Wizcat22/HeRo-Mini/Hardware/Part/PCB/Controller.step

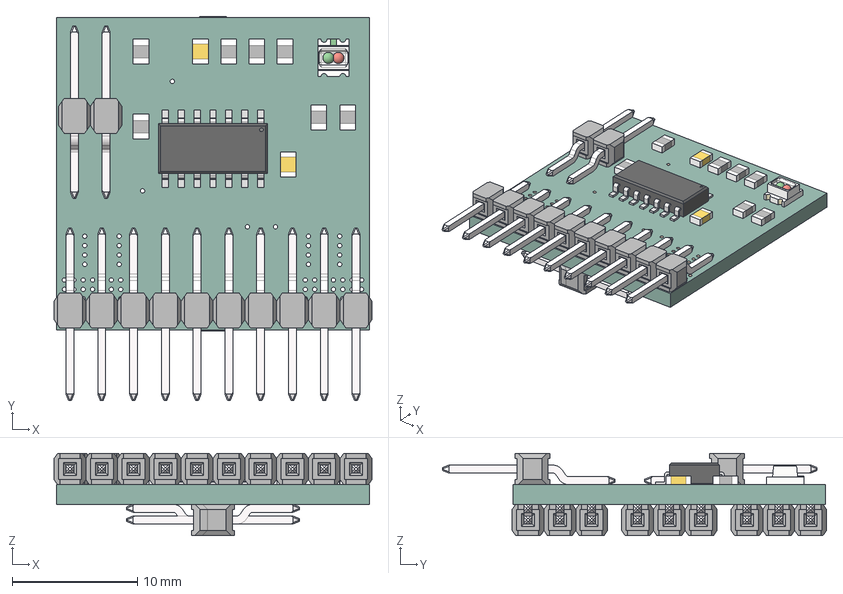
[picture p1: CAD file, 2018-07-30]
Hardware/Part/PCB/Controller.step
25.4 x 30.7 x 6.57 mm
Board
100nF x 2
10k x 7
ATTINY16142
1002386 | 00 | SL 1 IK x 6
1009987 | 00 | KSL 13,9 x 18
1002386 | 00 | SL 1 IK (1)
1009987 | 00 | KSL 13,9 (1) x 10
1002386 | 00 | SL 1 IK (2)
1009987 | 00 | KSL 13,9 (2) x 2
DUO_LED
