Wizcat22/HeRo-Mini/Hardware/STL/HIP.stl

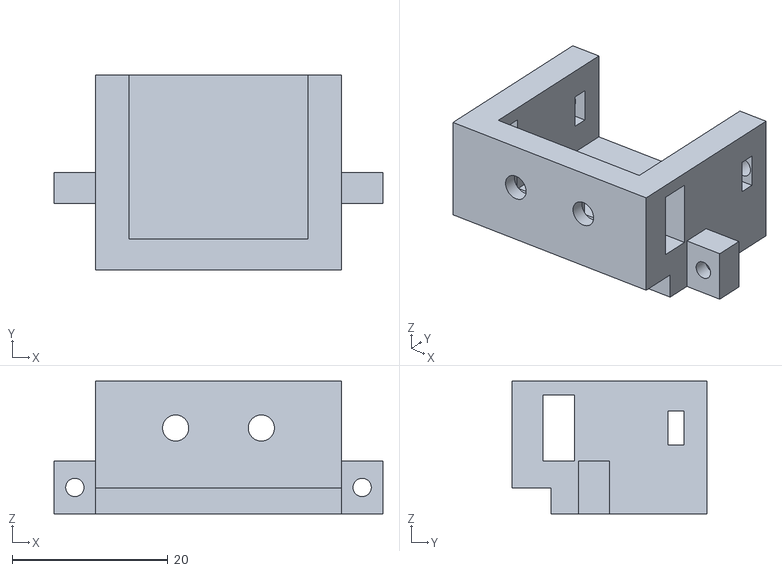
[picture p2: CAD file, 2018-09-26]
Hardware/STL/HIP.stl
42.2 x 25.0 x 17.0
