Wizcat22/HeRo-Mini/Hardware/STL/BODY_COVER.stl

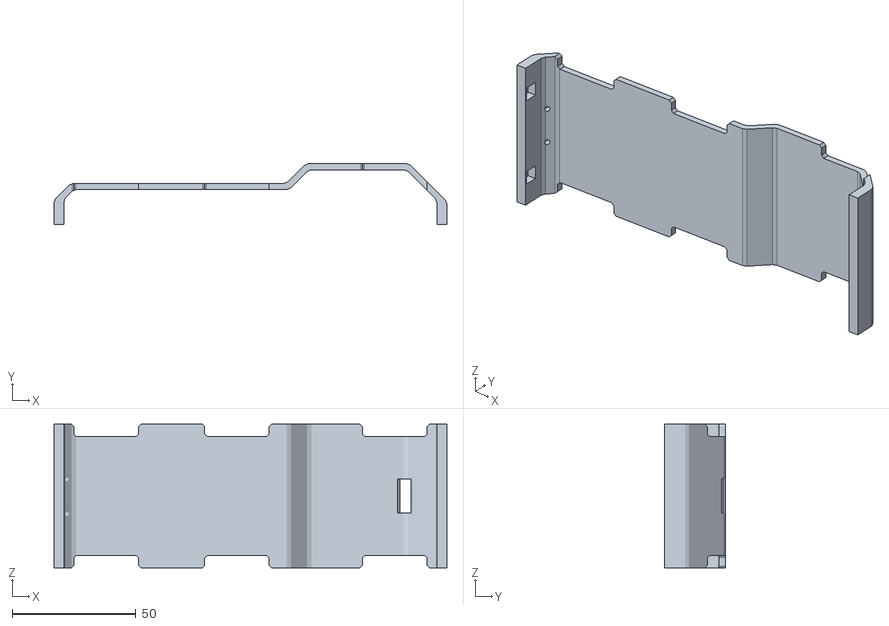
[picture p3: CAD file, 2018-09-26]
Hardware/STL/BODY_COVER.stl
158.7 x 24.6 x 58.0
