Wizcat22/HeRo-Mini/Hardware/STL/BODY_BOTTOM.stl

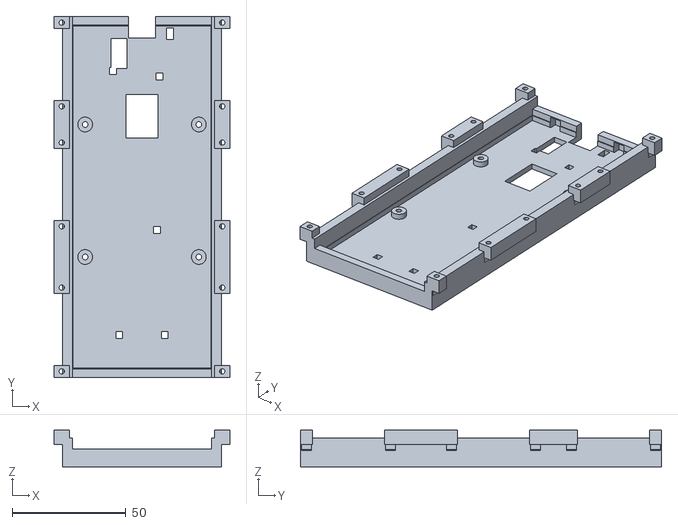
[picture p4: CAD file, 2018-09-26]
Hardware/STL/BODY_BOTTOM.stl
77.3 x 158.7 x 16.2
