Wizcat22/HeRo-Mini/Hardware/STL/FEMUR.stl

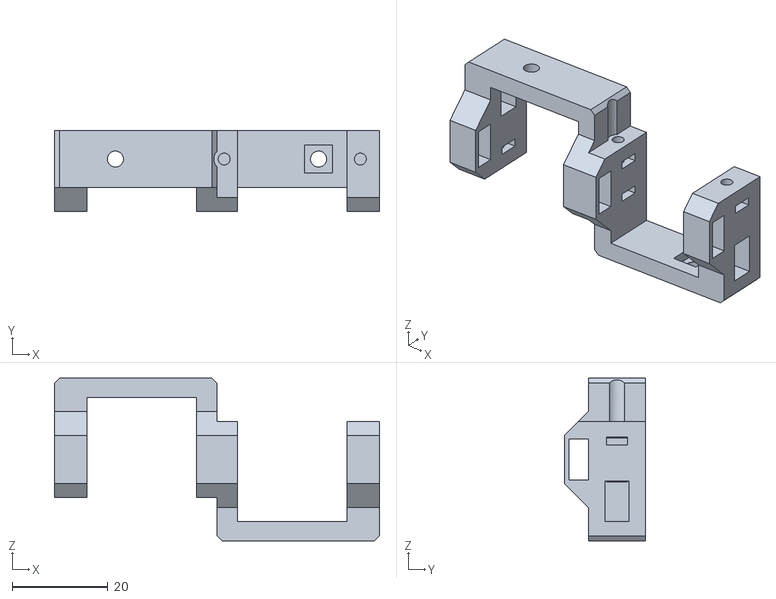
[picture p5: CAD file, 2018-09-26]
Hardware/STL/FEMUR.stl
68.0 x 17.0 x 34.0
