Wizcat22/HeRo-Mini/(list of files, cad)

Other CAD files:
Hardware/Assembly/Controller.iam
Hardware/Assembly/HeRoMini2.iam
Hardware/Assembly/LEG.iam
Hardware/Assembly/LEG2.iam
Hardware/Assembly/SERVO.iam
Hardware/Part/Design/BODY_BOTTOM.ipt
Hardware/Part/Design/BODY_COVER.ipt
Hardware/Part/Design/COXA.ipt
Hardware/Part/Design/FEMUR.ipt
Hardware/Part/Design/HIP.ipt
Hardware/Part/Design/TIBIA.ipt
Hardware/Part/Hardware/BEARING.ipt
Hardware/Part/Hardware/M2_SCREW_10MM.ipt
Hardware/Part/Hardware/M2_SCREW_6MM.ipt
Hardware/Part/Hardware/M2_SCREW_8MM.ipt
Hardware/Part/Hardware/M3_SCREW_20MM.ipt
Hardware/Part/Hardware/M3_SCREW_8MM.ipt
Hardware/Part/Hardware/M3_WASHER.ipt
Hardware/Part/Hardware/MAGNET.ipt
Hardware/Part/Hardware/NUT_2MM.ipt
Hardware/Part/Hardware/NUT_3MM.ipt
Hardware/Part/Hardware/OldVersions/M2_SCREW_10MM.0007.ipt
Hardware/Part/Misc/SPACER.ipt
Hardware/Part/Misc/TOLERANCE_TEST.ipt
Hardware/Part/Misc/TP-MG92B.ipt
Hardware/Part/Misc/TP-MG92B_HAT.ipt
Hardware/Part/PCB/IMU.ipt
Hardware/Part/PCB/Regulator1.ipt
Hardware/Part/PCB/Regulator2.ipt
