Wizcat22/HeRo-Mini/PCB/Prototype/Prototype.brd

## EAGLE design PCB/Prototype/Prototype.brd (2018-11-12)

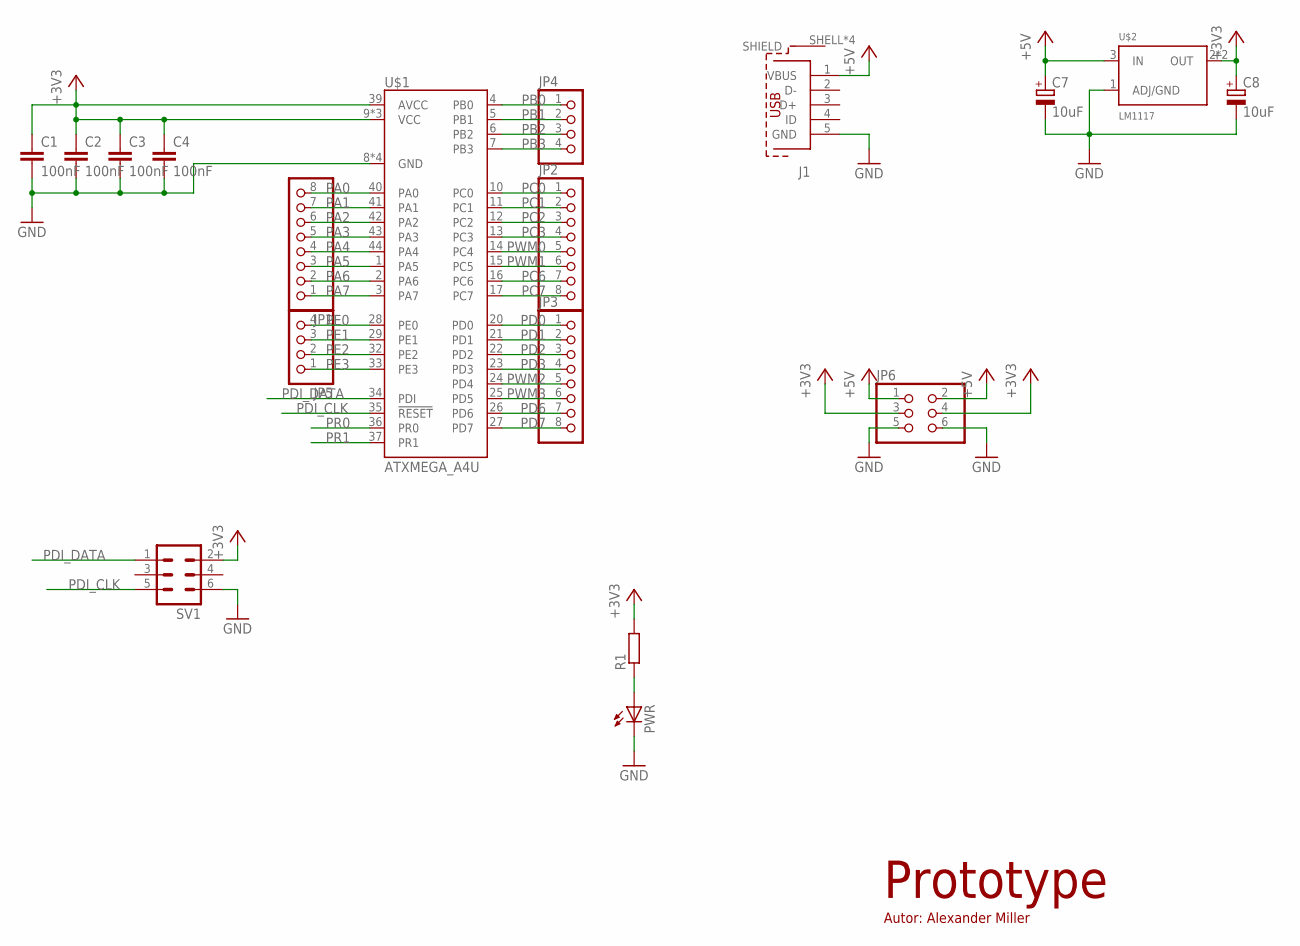
[picture p6: schematic Prototype.sch]

Parts:
C1, C2, C3, C4: 100nF; C0805
C7, C8: 10uF; SMC_P
J1: 629105136821
JP1, JP2, JP3: PINHD-1X8; 1X08
JP4, JP5: PINHD-1X4; 1X04
JP6: PINHD-2X3; 2X03
PWR: LEDSML0805; SML0805
R1: R-EU_R0805; R0805
SV1: ML6
U$1: ATXMEGA_A4U; QFP80P1200X1200X120-44
U$2: LM1117; SOT223

Connections:
+3V3: C1.1, C2.1, C3.1, C4.1, C8.+, JP6.3, JP6.4, R1.2, SV1.2, U$1.9 (VCC), U$1.19 (VCC), U$1.31 (VCC), U$1.39 (AVCC), U$2.2 (OUT), U$2.4 (OUT)
+5V: C7.+, J1.1 (VBUS), JP6.1, JP6.2, U$2.3 (IN)
GND: C1.2, C2.2, C3.2, C4.2, C7.-, C8.-, J1.5 (GND), JP6.5, JP6.6, PWR.C, SV1.6, U$1.8 (GND), U$1.18 (GND), U$1.30 (GND), U$1.38 (GND), U$2.1 (ADJ/GND)
unnamed: PWR.A, R1.1
PA0: JP1.8, U$1.40 (PA0)
PA1: JP1.7, U$1.41 (PA1)
PA2: JP1.6, U$1.42 (PA2)
PA3: JP1.5, U$1.43 (PA3)
PA4: JP1.4, U$1.44 (PA4)
PA5: JP1.3, U$1.1 (PA5)
PA6: JP1.2, U$1.2 (PA6)
PA7: JP1.1, U$1.3 (PA7)
PB0: JP4.1, U$1.4 (PB0)
PB1: JP4.2, U$1.5 (PB1)
PB2: JP4.3, U$1.6 (PB2)
PB3: JP4.4, U$1.7 (PB3)
PC0: JP2.1, U$1.10 (PC0)
PC1: JP2.2, U$1.11 (PC1)
PC2: JP2.3, U$1.12 (PC2)
PC3: JP2.4, U$1.13 (PC3)
PC6: JP2.7, U$1.16 (PC6)
PC7: JP2.8, U$1.17 (PC7)
PD0: JP3.1, U$1.20 (PD0)
PD1: JP3.2, U$1.21 (PD1)
PD2: JP3.3, U$1.22 (PD2)
PD3: JP3.4, U$1.23 (PD3)
PD6: JP3.7, U$1.26 (PD6)
PD7: JP3.8, U$1.27 (PD7)
PDI_CLK: SV1.5, U$1.35 (!RESET)
PDI_DATA: SV1.1, U$1.34 (PDI)
PE0: JP5.4, U$1.28 (PE0)
PE1: JP5.3, U$1.29 (PE1)
PE2: JP5.2, U$1.32 (PE2)
PE3: JP5.1, U$1.33 (PE3)
PR0: U$1.36 (PR0)
PR1: U$1.37 (PR1)
PWM0: JP2.5, U$1.14 (PC4)
PWM1: JP2.6, U$1.15 (PC5)
PWM2: JP3.5, U$1.24 (PD4)
PWM3: JP3.6, U$1.25 (PD5)

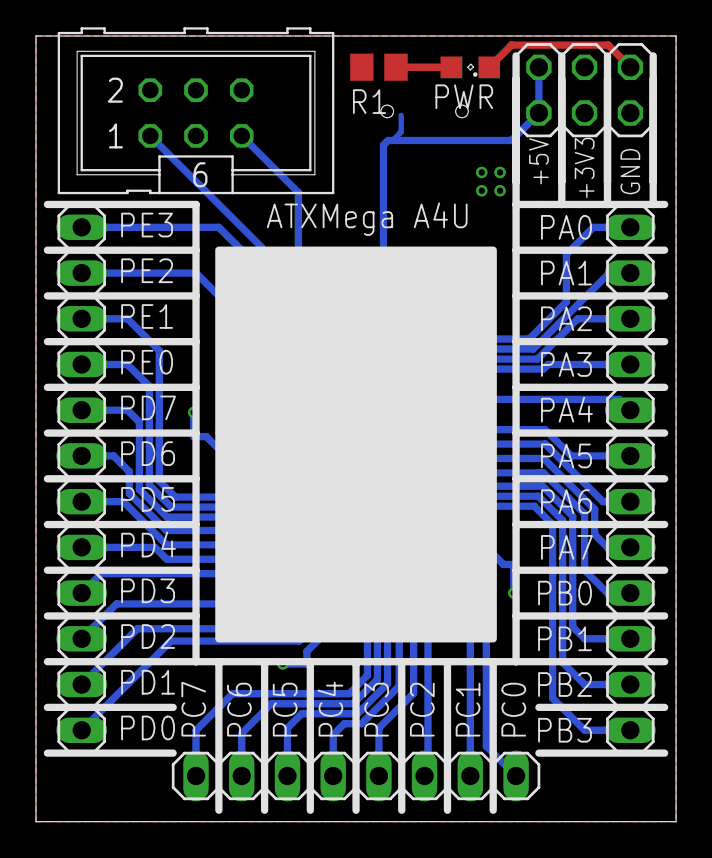
[picture p7: board Prototype.brd from above]

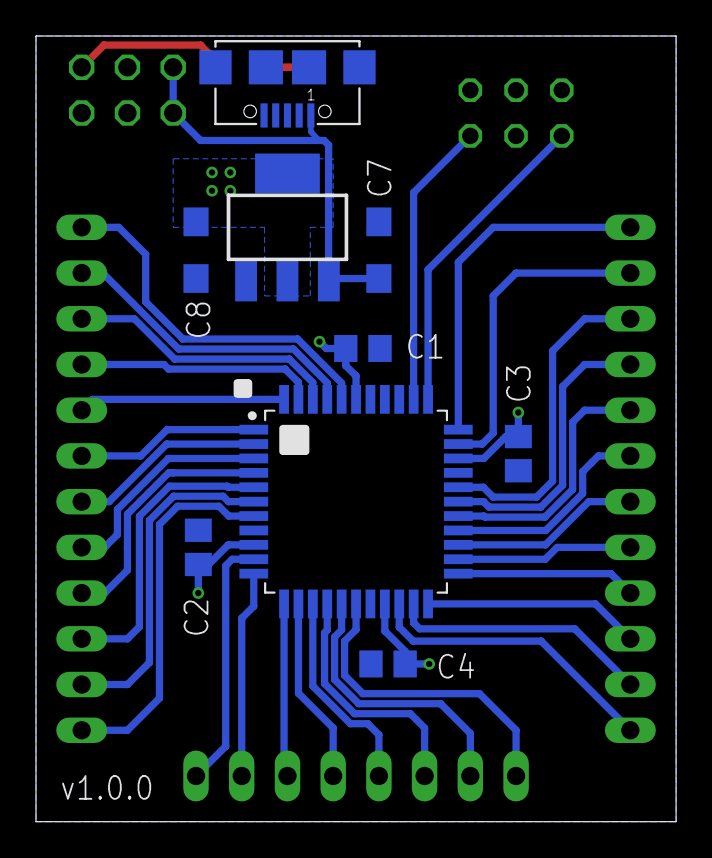
[picture p8: board Prototype.brd from below]

Board: 2 copper layers, 35.6 x 43.6 mm, 18 parts (9 on the bottom side), 38 nets.
