Wizcat22/HeRo-Mini/PCB/Gamepad/Gamepad.brd

## EAGLE design PCB/Gamepad/Gamepad.brd (2018-11-12)

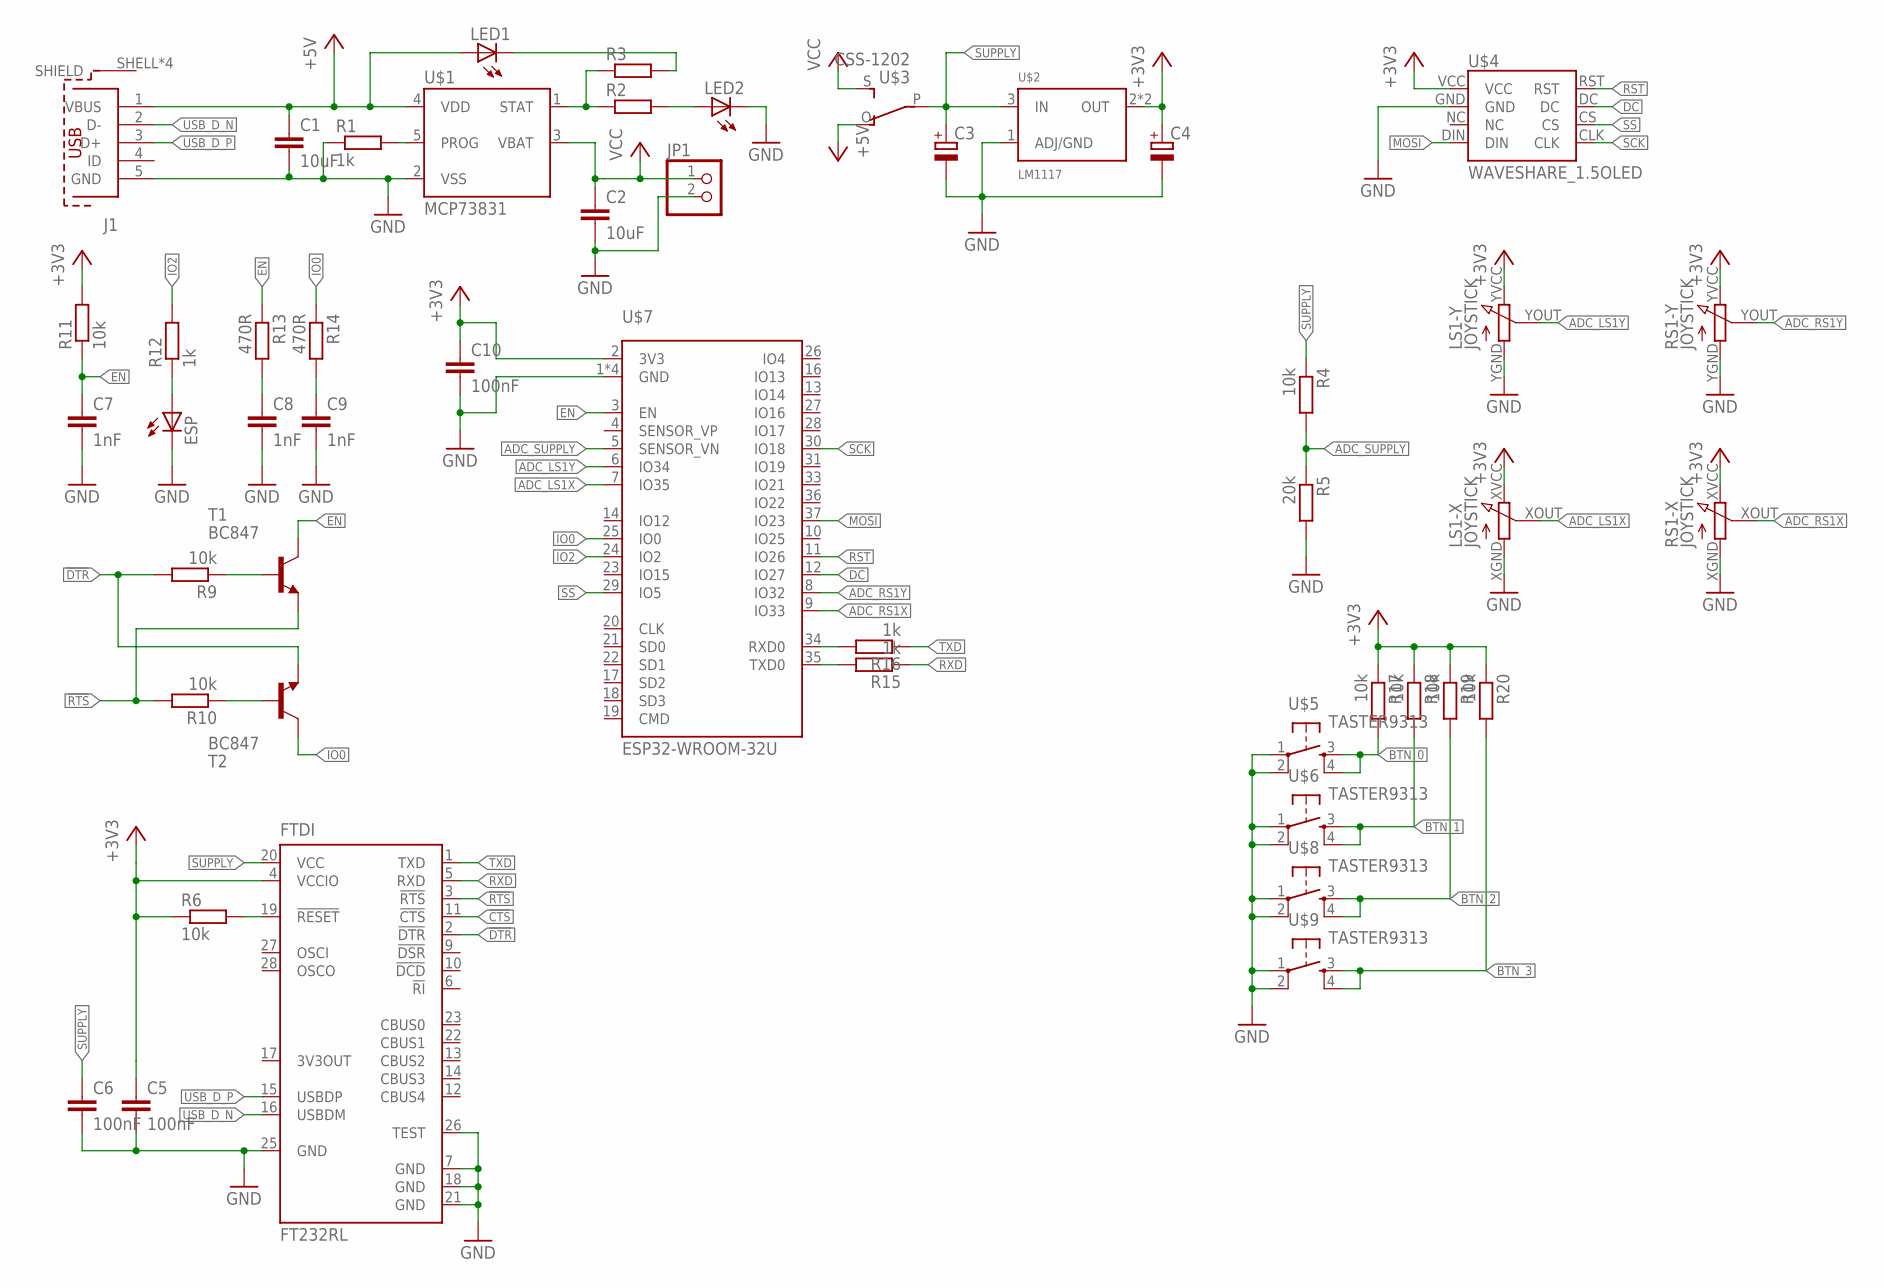
[picture p9: schematic Gamepad.sch]

Parts:
C1, C2: 10uF; C0805
C3, C4: CPOL-EUSMCP; SMC_P
C5, C6, C10: 100nF; C0805
C7, C8, C9: 1nF; C0805
ESP: LEDCHIP-LED0805; CHIP-LED0805
FTDI: FT232RL; SSOP28
J1: 629105136821
JP1: PINHD-1X2; 1X02
LED1, LED2: LED3MM
LS1: JOYSTICK
R1, R12, R15, R16: 1k; R0805
R2, R3: R-EU_R0805; R0805
R4, R6, R9, R10, R11, R17, R18, R19, R20: 10k; R0805
R5: 20k; R0805
R13, R14: 470R; R0805
RS1: JOYSTICK
T1, T2: BC847; SOT23
U$1: MCP73831; SOT95P280X145-5
U$2: LM1117; SOT223
U$3: CSS-1202
U$4: WAVESHARE_1.5OLED
U$5, U$6, U$8, U$9: TASTER9313
U$7: ESP32-WROOM-32U

Connections:
!CTS: FTDI.11 (!CTS)
!DTR: FTDI.2 (!DTR), R9.2, T2.2 (E)
!RTS: FTDI.3 (!RTS), R10.2, T1.2 (E)
+3V3: C4.+, C5.1, C10.1, FTDI.4 (VCCIO), LS1.XVCC (VCC), LS1.YVCC (VCC), R6.1, R11.2, R17.1, R18.1, R19.1, R20.1, RS1.XVCC (VCC), RS1.YVCC (VCC), U$2.2 (OUT), U$2.4 (OUT), U$4.VCC, U$7.2 (3V3)
+5V: C1.1, J1.1 (VBUS), LED1.A, U$1.4 (VDD), U$3.O
ADC_LS1X: LS1.XOUT (OUT), U$7.7 (IO35)
ADC_LS1Y: LS1.YOUT (OUT), U$7.6 (IO34)
ADC_RS1X: RS1.XOUT (OUT), U$7.9 (IO33)
ADC_RS1Y: RS1.YOUT (OUT), U$7.8 (IO32)
ADC_SUPPLY: R4.2, R5.1, U$7.5 (SENSOR_VN)
BTN_0: R17.2, U$5.3 (S), U$5.4 (S1)
BTN_1: R18.2, U$6.3 (S), U$6.4 (S1)
BTN_2: R19.2, U$8.3 (S), U$8.4 (S1)
BTN_3: R20.2, U$9.3 (S), U$9.4 (S1)
DC: U$4.DC, U$7.12 (IO27)
EN: C7.1, R11.1, R13.1, T1.3 (C), U$7.3 (EN)
GND: C1.2, C2.2, C3.-, C4.-, C5.2, C6.2, C7.2, C8.2, C9.2, C10.2, ESP.C, FTDI.7 (GND), FTDI.18 (GND), FTDI.21 (GND), FTDI.25 (GND), FTDI.26 (TEST), J1.5 (GND), JP1.2, LED2.K (C), LS1.XGND (GND), LS1.YGND (GND), R1.1, R5.2, RS1.XGND (GND), RS1.YGND (GND), U$1.2 (VSS), U$2.1 (ADJ/GND), U$4.GND, U$5.1, U$5.2 (P1), U$6.1, U$6.2 (P1), U$7.1 (GND), U$7.15 (GND), U$7.38 (GND), U$7.39 (GND), U$8.1, U$8.2 (P1), U$9.1, U$9.2 (P1)
IO0: R14.1, T2.3 (C), U$7.25 (IO0)
IO2: R12.2, U$7.24 (IO2)
MOSI: U$4.DIN, U$7.37 (IO23)
unnamed: R2.1, R3.1, U$1.1 (STAT)
unnamed: FTDI.19 (!RESET), R6.2
unnamed: R1.2, U$1.5 (PROG)
unnamed: LED1.K (C), R3.2
unnamed: LED2.A, R2.2
unnamed: R9.1, T1.1 (B)
unnamed: R10.1, T2.1 (B)
unnamed: ESP.A, R12.1
unnamed: C8.1, R13.2
unnamed: C9.1, R14.2
unnamed: R16.2, U$7.34 (RXD0)
unnamed: R15.2, U$7.35 (TXD0)
RST: U$4.RST, U$7.11 (IO26)
RXD: FTDI.5 (RXD), R15.1
SCK: U$4.CLK, U$7.30 (IO18)
SS: U$4.CS, U$7.29 (IO5)
SUPPLY: C3.+, C6.1, FTDI.20 (VCC), R4.1, U$2.3 (IN), U$3.P
TXD: FTDI.1 (TXD), R16.1
USB_D_N: FTDI.16 (USBDM), J1.2 (D-)
USB_D_P: FTDI.15 (USBDP), J1.3 (D+)
VCC: C2.1, JP1.1, U$1.3 (VBAT), U$3.S

Board: 2 copper layers, 47 parts (31 on the bottom side), 40 nets, no tracks yet.
