Wizcat22/HeRo-Mini/PCB/Mainboard/Mainboard.brd

## EAGLE design PCB/Mainboard/Mainboard.brd (2018-07-30)

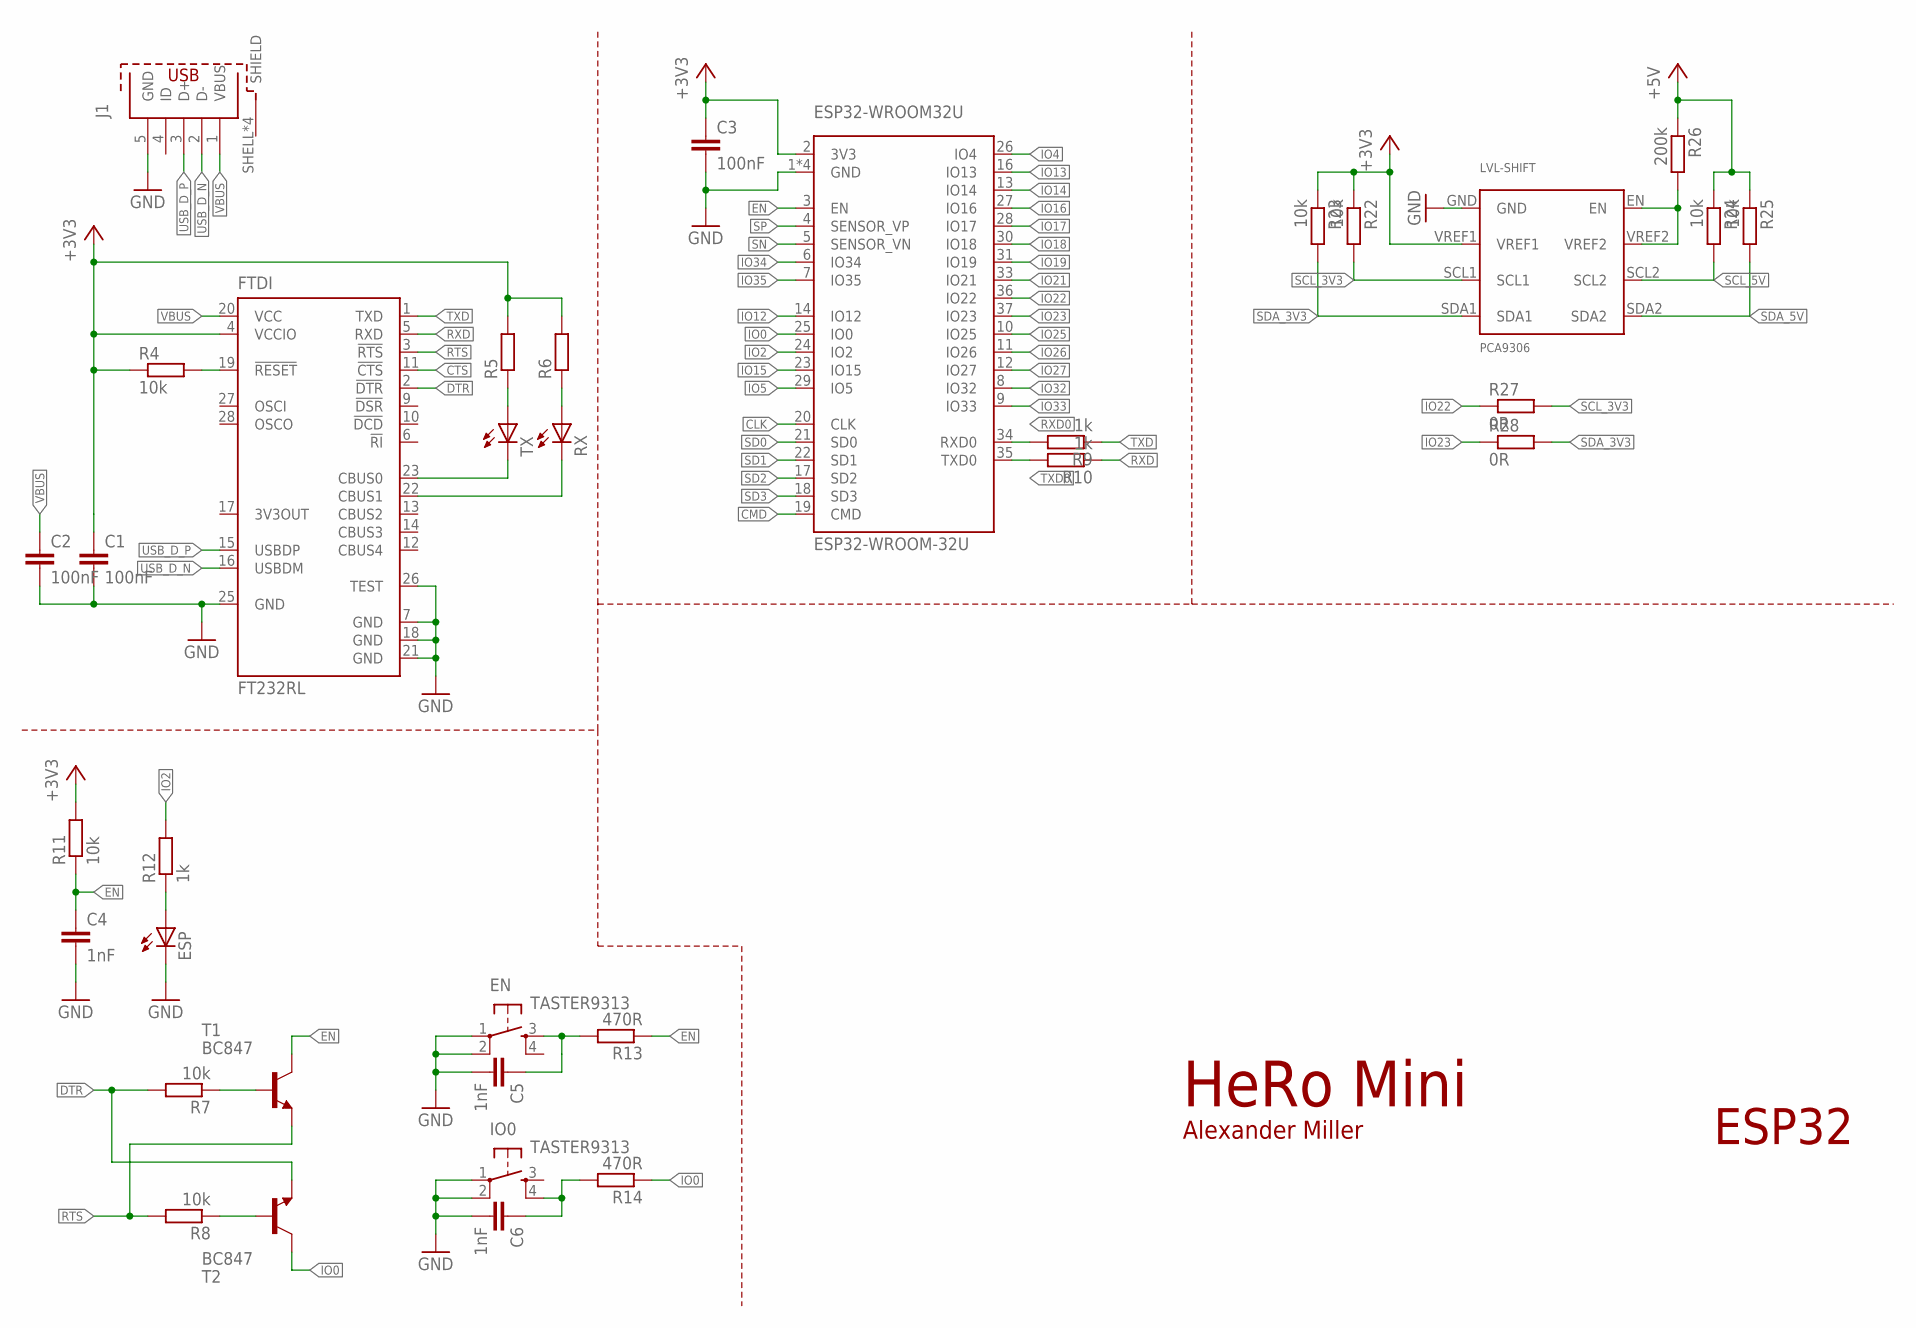
[picture p10: schematic Mainboard.sch, sheet 1]

Parts:
C1, C2, C3: 100nF; C0805
C4, C5, C6: 1nF; C0805
EN: TASTER9313
ESP: LEDCHIP-LED0805; CHIP-LED0805
ESP32-WROOM32U: ESP32-WROOM-32U
FTDI: FT232RL; SSOP28
IO0: TASTER9313
J1: 629105136821
LVL-SHIFT: PCA9306
R4, R7, R8, R11, R22, R23, R24, R25: 10k; R0805
R5, R6: R-EU_R0805; R0805
R9, R10, R12: 1k; R0805
R13, R14: 470R; R0805
R26: 200k; R0805
R27, R28: 0R; R0805
RX: LEDCHIP-LED0805; CHIP-LED0805
T1, T2: BC847; SOT23
TX: LEDCHIP-LED0805; CHIP-LED0805

Connections:
!CTS: FTDI.11 (!CTS)
!DTR: FTDI.2 (!DTR), R7.2, T2.2 (E)
!RTS: FTDI.3 (!RTS), R8.2, T1.2 (E)
+3V3: C1.1, C3.1, ESP32-WROOM32U.2 (3V3), FTDI.4 (VCCIO), LVL-SHIFT.VREF1, R4.1, R5.2, R6.2, R11.2, R22.1, R23.1; also elsewhere on the board
+5V: R24.1, R25.1, R26.1; also elsewhere on the board
CLK: ESP32-WROOM32U.20 (CLK)
CMD: ESP32-WROOM32U.19 (CMD)
EN: C4.1, ESP32-WROOM32U.3 (EN), R11.1, R13.1, T1.3 (C)
GND: C1.2, C2.2, C3.2, C4.2, C5.2, C6.2, EN.1, EN.2 (P1), ESP.C, ESP32-WROOM32U.1 (GND), ESP32-WROOM32U.15 (GND), ESP32-WROOM32U.38 (GND), ESP32-WROOM32U.39 (GND), FTDI.7 (GND), FTDI.18 (GND), FTDI.21 (GND), FTDI.25 (GND), FTDI.26 (TEST), IO0.1, IO0.2 (P1), J1.5 (GND), LVL-SHIFT.GND; also elsewhere on the board
IO0: ESP32-WROOM32U.25 (IO0), R14.1, T2.3 (C)
IO2: ESP32-WROOM32U.24 (IO2), R12.2
IO4: ESP32-WROOM32U.26 (IO4)
IO5: ESP32-WROOM32U.29 (IO5)
IO12: ESP32-WROOM32U.14 (IO12)
IO13: ESP32-WROOM32U.16 (IO13)
IO14: ESP32-WROOM32U.13 (IO14)
IO15: ESP32-WROOM32U.23 (IO15)
IO16: ESP32-WROOM32U.27 (IO16)
IO17: ESP32-WROOM32U.28 (IO17)
IO18: ESP32-WROOM32U.30 (IO18)
IO19: ESP32-WROOM32U.31 (IO19)
IO21: ESP32-WROOM32U.33 (IO21)
IO22: ESP32-WROOM32U.36 (IO22), R27.1
IO23: ESP32-WROOM32U.37 (IO23), R28.1
IO25: ESP32-WROOM32U.10 (IO25)
IO26: ESP32-WROOM32U.11 (IO26)
IO27: ESP32-WROOM32U.12 (IO27)
IO32: ESP32-WROOM32U.8 (IO32)
IO33: ESP32-WROOM32U.9 (IO33)
IO34: ESP32-WROOM32U.6 (IO34)
IO35: ESP32-WROOM32U.7 (IO35)
unnamed: FTDI.19 (!RESET), R4.2
unnamed: FTDI.23 (CBUS0), TX.C
unnamed: FTDI.22 (CBUS1), RX.C
unnamed: R5.1, TX.A
unnamed: R6.1, RX.A
unnamed: R7.1, T1.1 (B)
unnamed: R8.1, T2.1 (B)
unnamed: ESP.A, R12.1
unnamed: C5.1, EN.3 (S), R13.2
unnamed: C6.1, IO0.4 (S1), R14.2
unnamed: LVL-SHIFT.EN, LVL-SHIFT.VREF2, R26.2
RXD: FTDI.5 (RXD), R10.1
RXD0: ESP32-WROOM32U.34 (RXD0), R9.2
SCL_3V3: LVL-SHIFT.SCL1, R22.2, R27.2
SCL_5V: LVL-SHIFT.SCL2, R24.2; also elsewhere on the board
SD0: ESP32-WROOM32U.21 (SD0)
SD1: ESP32-WROOM32U.22 (SD1)
SD2: ESP32-WROOM32U.17 (SD2)
SD3: ESP32-WROOM32U.18 (SD3)
SDA_3V3: LVL-SHIFT.SDA1, R23.2, R28.2
SDA_5V: LVL-SHIFT.SDA2, R25.2; also elsewhere on the board
SN: ESP32-WROOM32U.5 (SENSOR_VN)
SP: ESP32-WROOM32U.4 (SENSOR_VP)
TXD: FTDI.1 (TXD), R9.1
TXD0: ESP32-WROOM32U.35 (TXD0), R10.2
USB_D_N: FTDI.16 (USBDM), J1.2 (D-)
USB_D_P: FTDI.15 (USBDP), J1.3 (D+)
VBUS: C2.1, FTDI.20 (VCC), J1.1 (VBUS)

Notes on the sheet:
ESP32

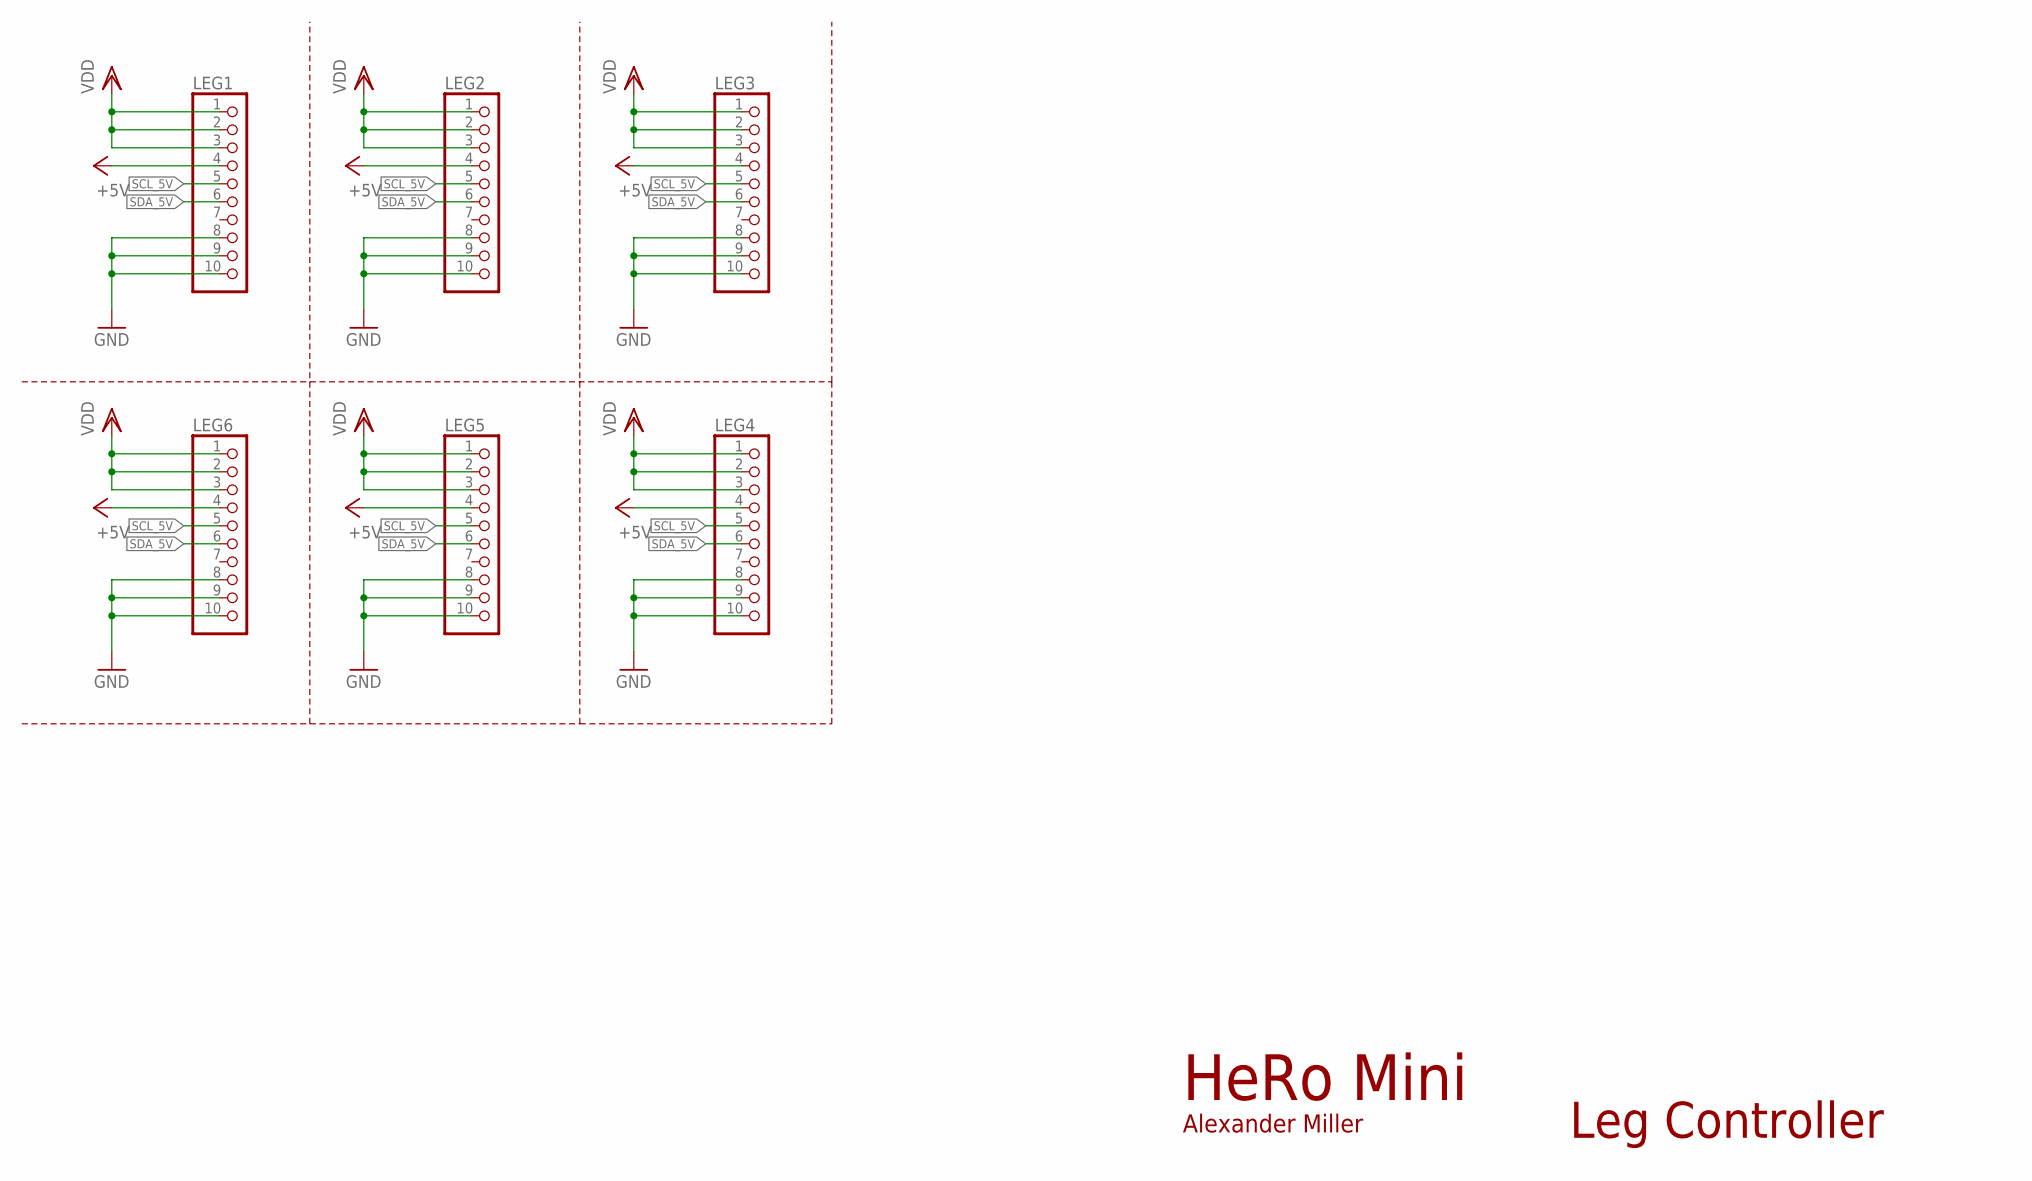
[picture p11: schematic Mainboard.sch, sheet 2]

Parts:
LEG1, LEG2, LEG3, LEG4, LEG5, LEG6: PINHD-1X10; 1X10

Connections:
+5V: LEG1.4, LEG2.4, LEG3.4, LEG4.4, LEG5.4, LEG6.4; also elsewhere on the board
GND: LEG1.8, LEG1.9, LEG1.10, LEG2.8, LEG2.9, LEG2.10, LEG3.8, LEG3.9, LEG3.10, LEG4.8, LEG4.9, LEG4.10, LEG5.8, LEG5.9, LEG5.10, LEG6.8, LEG6.9, LEG6.10; also elsewhere on the board
SCL_5V: LEG1.5, LEG2.5, LEG3.5, LEG4.5, LEG5.5, LEG6.5; also elsewhere on the board
SDA_5V: LEG1.6, LEG2.6, LEG3.6, LEG4.6, LEG5.6, LEG6.6; also elsewhere on the board
VDD: LEG1.1, LEG1.2, LEG1.3, LEG2.1, LEG2.2, LEG2.3, LEG3.1, LEG3.2, LEG3.3, LEG4.1, LEG4.2, LEG4.3, LEG5.1, LEG5.2, LEG5.3, LEG6.1, LEG6.2, LEG6.3; also elsewhere on the board

Notes on the sheet:
Leg Controller

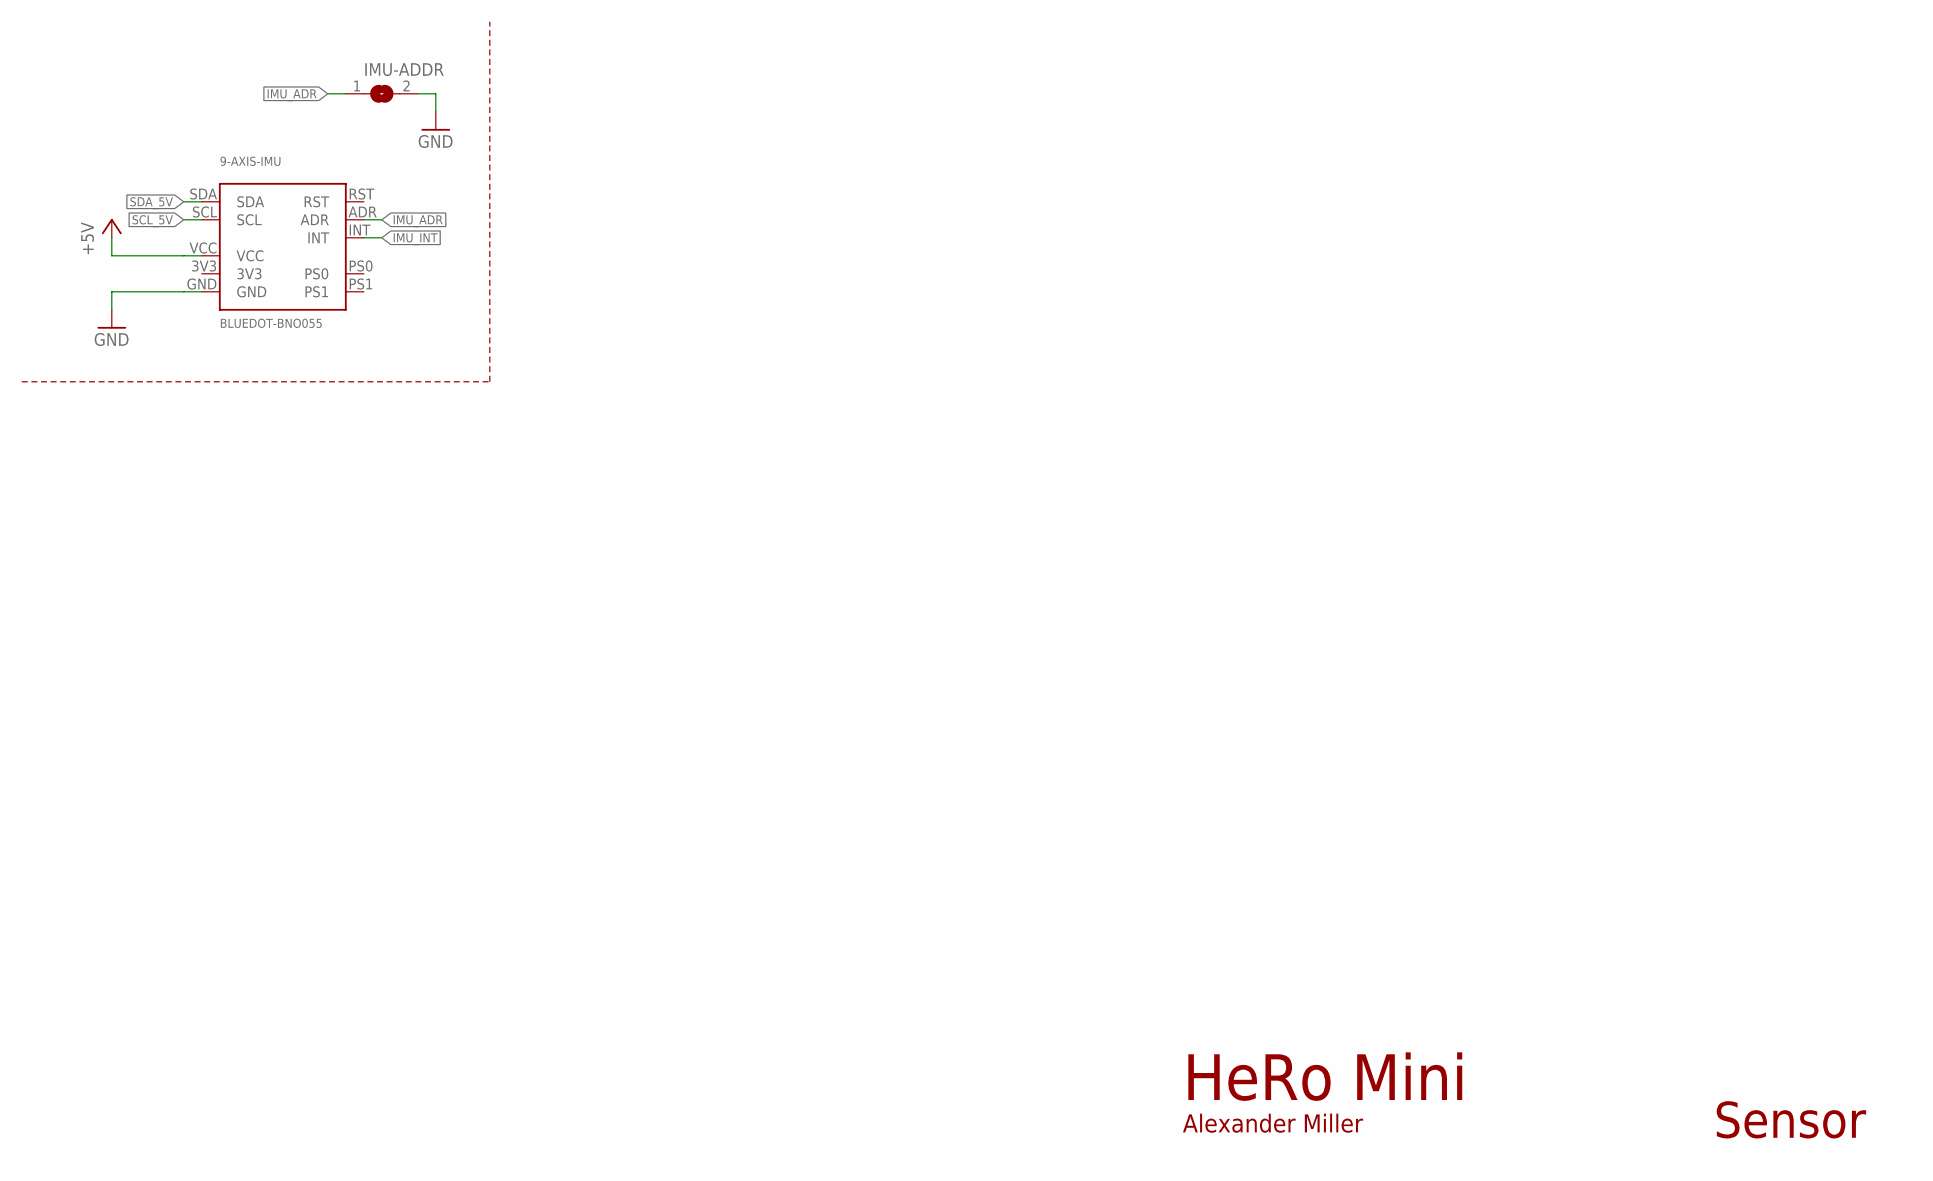
[picture p12: schematic Mainboard.sch, sheet 3]

Parts:
9-AXIS-IMU: BLUEDOT-BNO055
IMU-ADDR: SJ

Connections:
+5V: 9-AXIS-IMU.VCC; also elsewhere on the board
GND: 9-AXIS-IMU.GND, IMU-ADDR.2; also elsewhere on the board
IMU_ADR: 9-AXIS-IMU.ADR, IMU-ADDR.1
IMU_INT: 9-AXIS-IMU.INT
SCL_5V: 9-AXIS-IMU.SCL; also elsewhere on the board
SDA_5V: 9-AXIS-IMU.SDA; also elsewhere on the board

Notes on the sheet:
Sensor

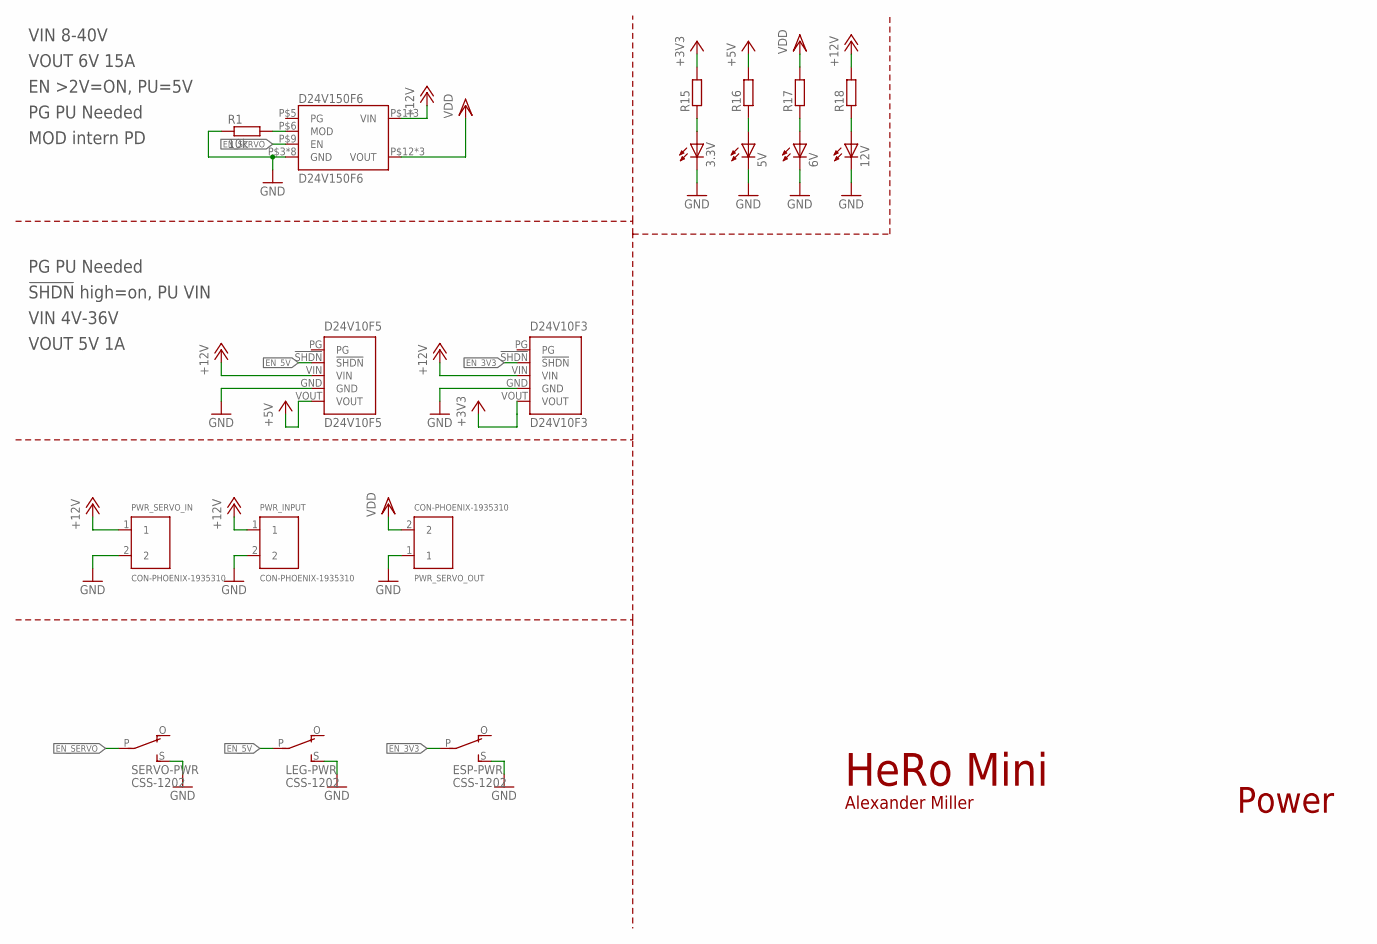
[picture p13: schematic Mainboard.sch, sheet 4]

Parts:
3.3V, 5V, 6V, 12V: LEDCHIP-LED0805; CHIP-LED0805
D24V10F3: D24V10F3; D24V10F5
D24V10F5: D24V10F5
D24V150F6: D24V150F6
ESP-PWR: CSS-1202
LEG-PWR: CSS-1202
PWR_INPUT: CON-PHOENIX-1935310
PWR_SERVO_IN: CON-PHOENIX-1935310
PWR_SERVO_OUT: CON-PHOENIX-1935310
R1: 10k; R0805
R15, R16, R17, R18: R-EU_R0805; R0805
SERVO-PWR: CSS-1202

Connections:
+3V3: D24V10F3.VOUT, R15.2; also elsewhere on the board
+5V: D24V10F5.VOUT, R16.2; also elsewhere on the board
+12V: D24V10F3.VIN, D24V10F5.VIN, D24V150F6.P$1 (VIN), D24V150F6.P$2 (VIN), D24V150F6.P$17 (VIN), PWR_INPUT.1, PWR_SERVO_IN.1, R18.2
EN_3V3: D24V10F3.!SHDN, ESP-PWR.P
EN_5V: D24V10F5.!SHDN, LEG-PWR.P
EN_SERVO: D24V150F6.P$9 (EN), SERVO-PWR.P
GND: 3.3V.C, 5V.C, 6V.C, 12V.C, D24V10F3.GND, D24V10F5.GND, D24V150F6.P$3 (GND), D24V150F6.P$4 (GND), D24V150F6.P$7 (GND), D24V150F6.P$8 (GND), D24V150F6.P$10 (GND), D24V150F6.P$11 (GND), D24V150F6.P$14 (GND), D24V150F6.P$16 (GND), ESP-PWR.S, LEG-PWR.S, PWR_INPUT.2, PWR_SERVO_IN.2, PWR_SERVO_OUT.1, R1.1, SERVO-PWR.S; also elsewhere on the board
unnamed: D24V150F6.P$6 (MOD), R1.2
unnamed: 5V.A, R16.1
unnamed: 6V.A, R17.1
unnamed: 3.3V.A, R15.1
unnamed: 12V.A, R18.1
VDD: D24V150F6.P$12 (VOUT), D24V150F6.P$13 (VOUT), D24V150F6.P$15 (VOUT), PWR_SERVO_OUT.2, R17.2; also elsewhere on the board

Notes on the sheet:
Power
VIN 8-40V
VOUT 6V 15A
EN >2V=ON, PU=5V
PG PU Needed
MOD intern PD
!SHDN! high=on, PU VIN
VIN 4V-36V
VOUT 5V 1A

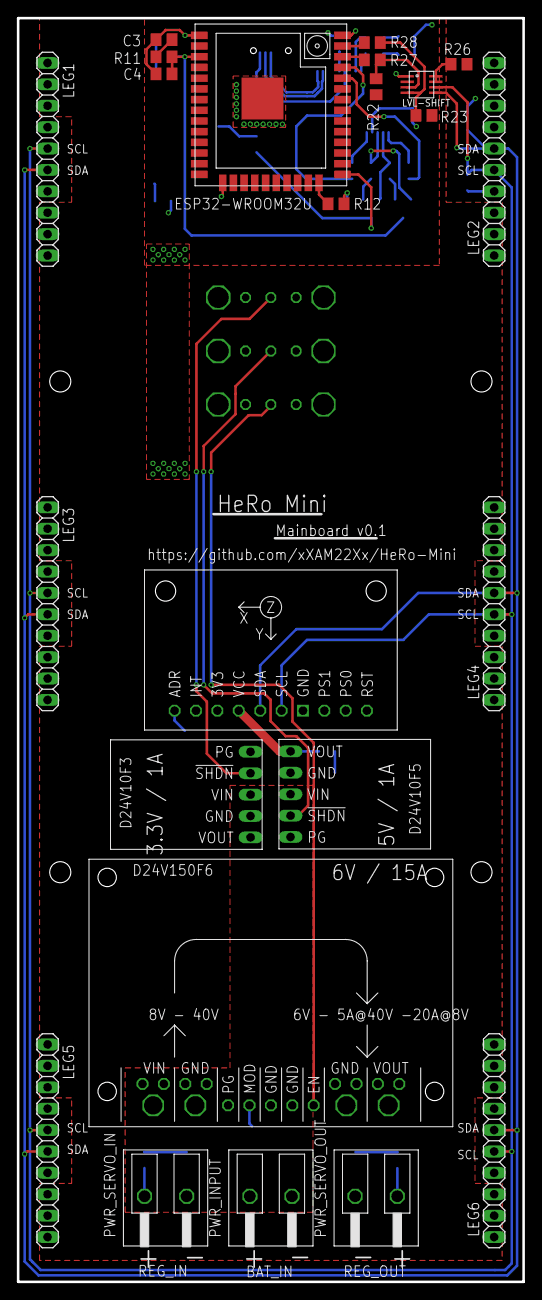
[picture p14: board Mainboard.brd from above]

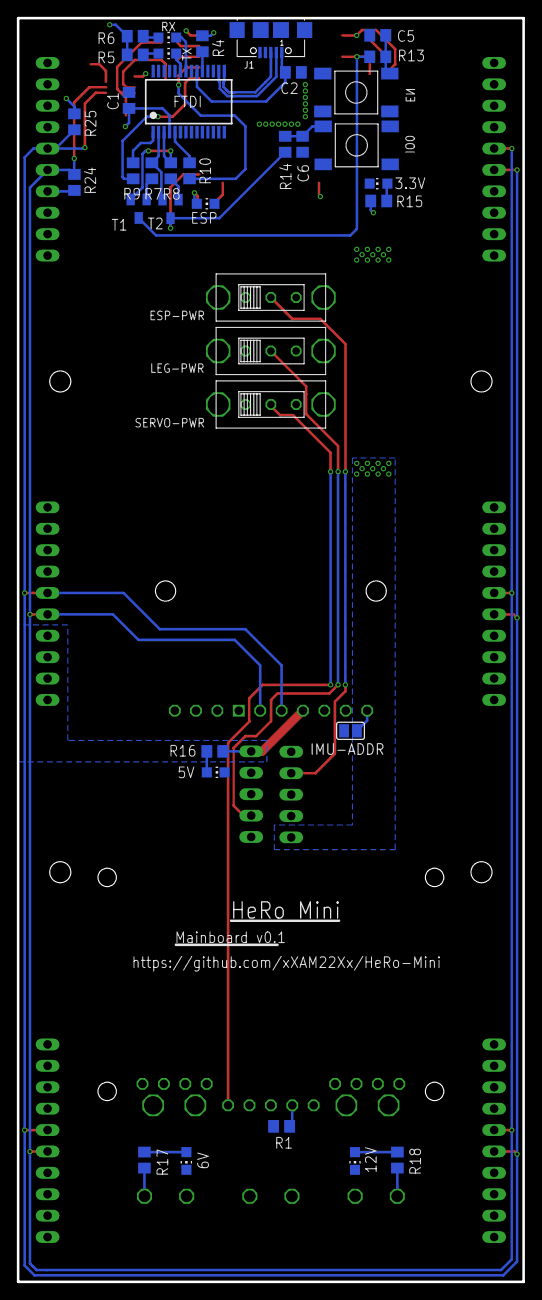
[picture p15: board Mainboard.brd from below]

Board: 2 copper layers, 60.0 x 150.0 mm, 61 parts (37 on the bottom side), 43 nets.
