Wizcat22/HeRo-Mini/PCB/Controller/Controller.brd

## EAGLE design PCB/Controller/Controller.brd (2018-07-30)

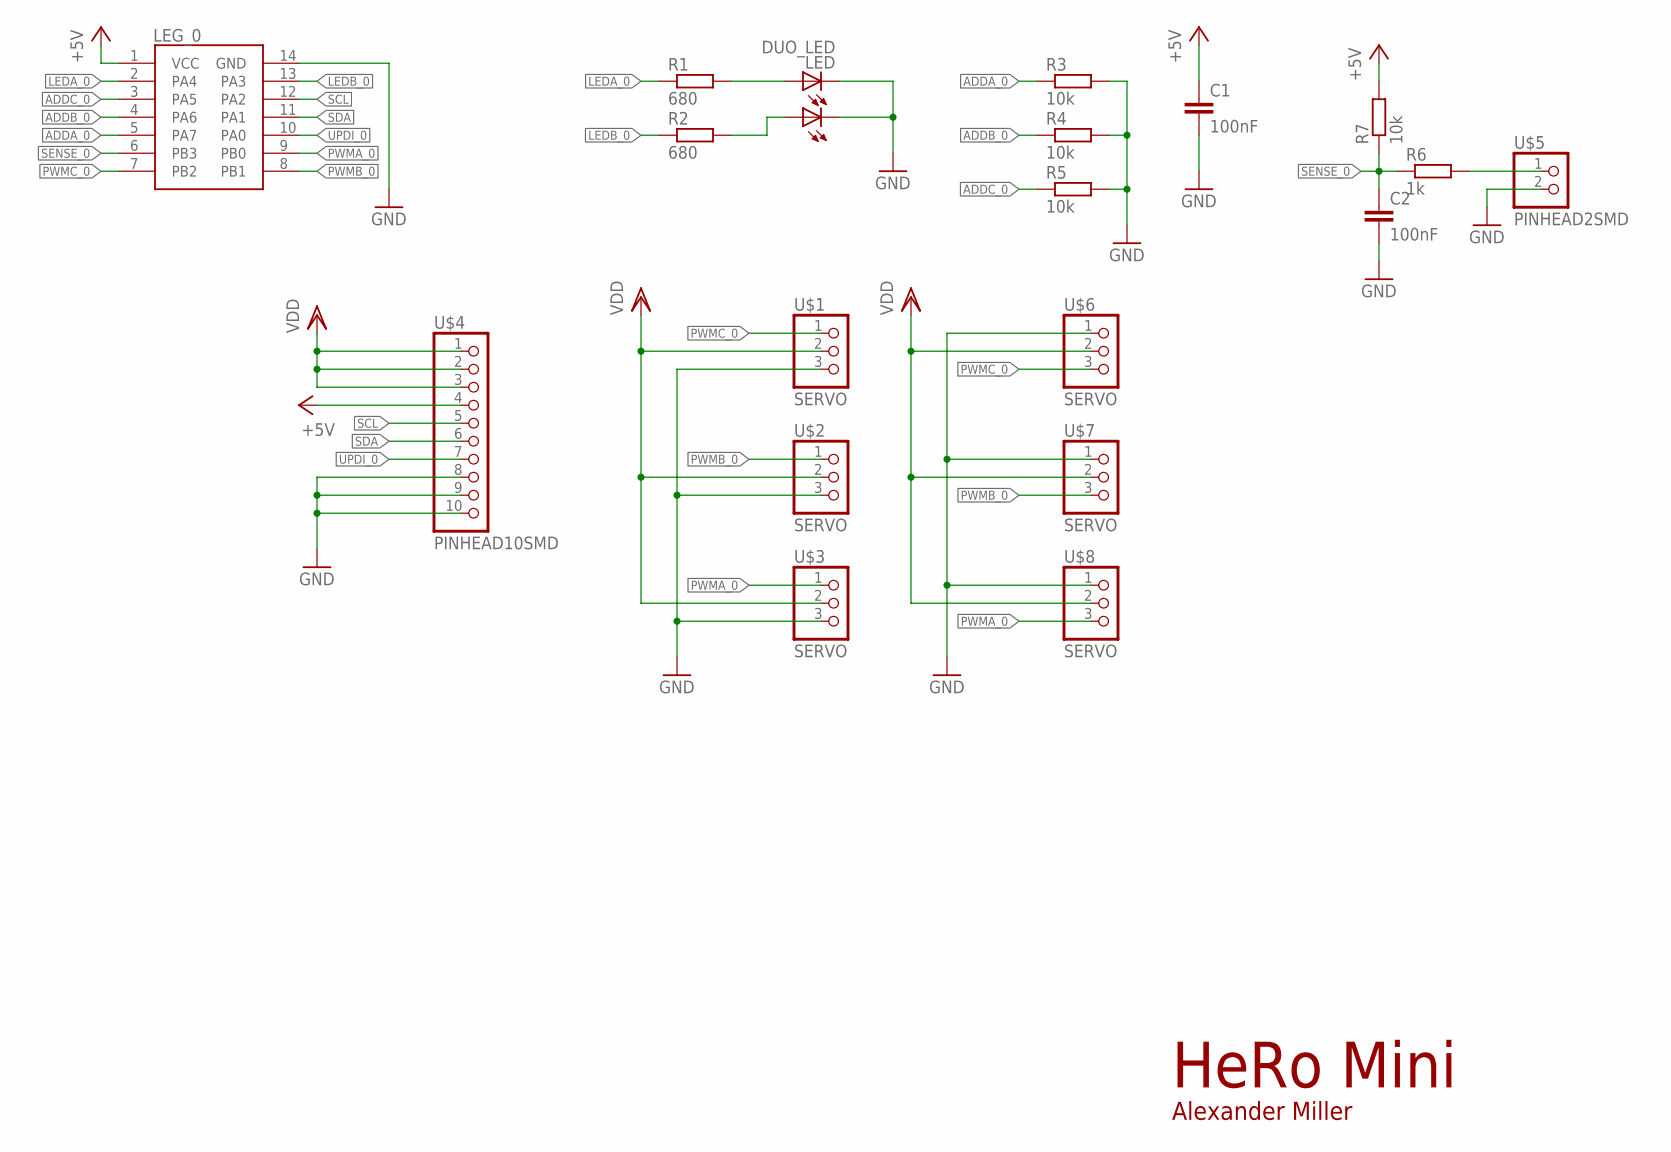
[picture p16: schematic Controller.sch, sheet 1]

Parts:
C1, C2: 100nF; C0805
LED: DUO_LED
LEG_0: ATTINY16142; SOIC127P600X175-14
R1, R2: 680; R0805
R3, R4, R5, R7: 10k; R0805
R6: 1k; R0805
U$1, U$2, U$3, U$6, U$7, U$8: SERVO; SL12SMD058
U$4: PINHEAD10SMD; PINHD10SMD
U$5: PINHEAD2SMD; PINHD2SMD

Connections:
+5V: C1.1, LEG_0.1 (VCC), R7.2, U$4.4
ADDA_0: LEG_0.5 (PA7), R3.1
ADDB_0: LEG_0.4 (PA6), R4.1
ADDC_0: LEG_0.3 (PA5), R5.1
GND: C1.2, C2.2, LED.CG, LED.CR, LEG_0.14 (GND), R3.2, R4.2, R5.2, U$1.3, U$2.3, U$3.3, U$4.8, U$4.9, U$4.10, U$5.2, U$6.1, U$7.1, U$8.1
LEDA_0: LEG_0.2 (PA4), R1.1
LEDB_0: LEG_0.13 (PA3), R2.1
unnamed: LED.AG, R1.2
unnamed: LED.AR, R2.2
unnamed: R6.2, U$5.1
PWMA_0: LEG_0.9 (PB0), U$3.1, U$8.3
PWMB_0: LEG_0.8 (PB1), U$2.1, U$7.3
PWMC_0: LEG_0.7 (PB2), U$1.1, U$6.3
SCL: LEG_0.12 (PA2), U$4.5
SDA: LEG_0.11 (PA1), U$4.6
SENSE_0: C2.1, LEG_0.6 (PB3), R6.1, R7.1
UPDI_0: LEG_0.10 (PA0), U$4.7
VDD: U$1.2, U$2.2, U$3.2, U$4.1, U$4.2, U$4.3, U$6.2, U$7.2, U$8.2

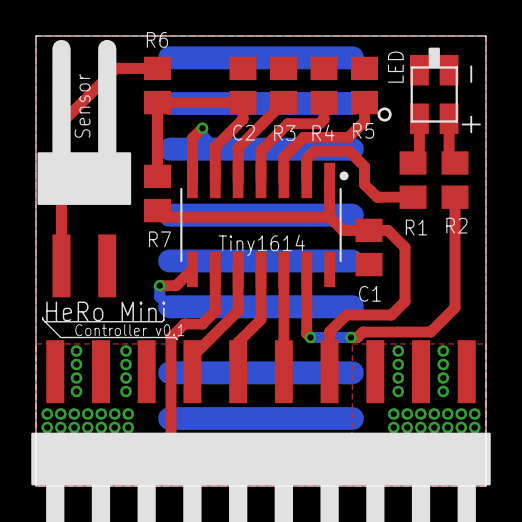
[picture p17: board Controller.brd from above]

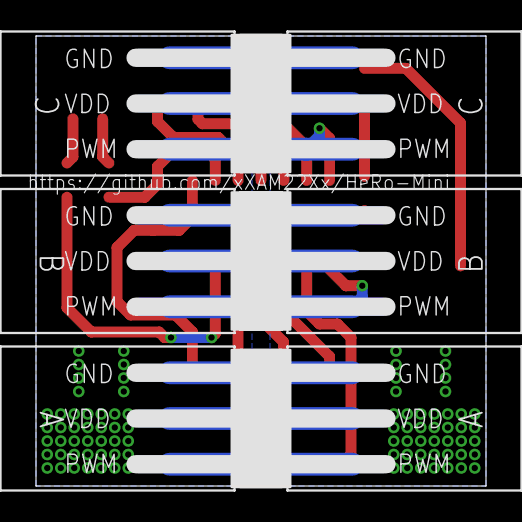
[picture p18: board Controller.brd from below]

Board: 2 copper layers, 25.0 x 25.0 mm, 19 parts (6 on the bottom side), 18 nets.
