Wizcat22/HeRo-Mini/PCB/2x2_DPad.brd

## EAGLE design PCB/2x2_DPad.brd (2018-03-26)

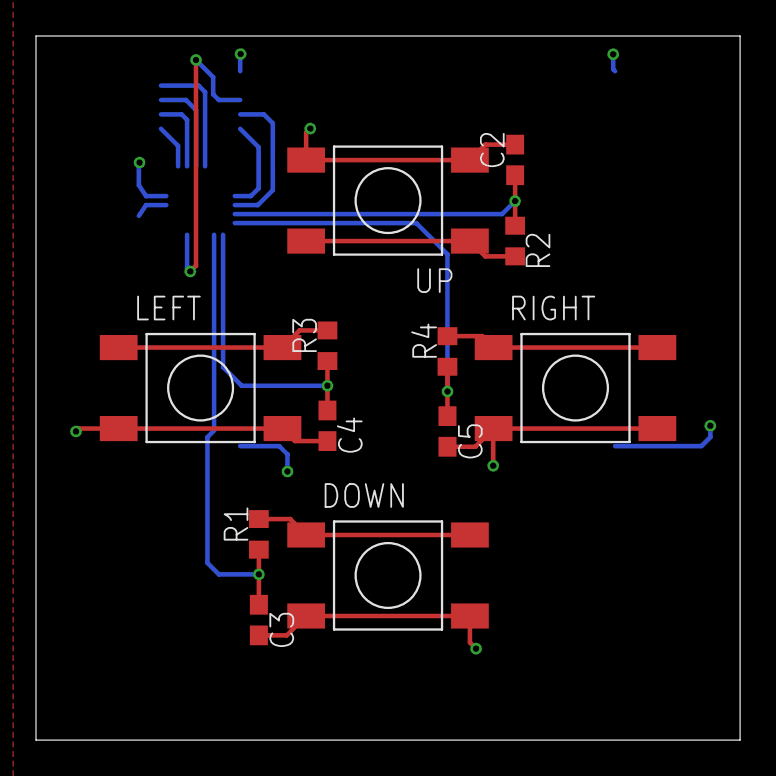
[picture p19: board 2x2_DPad.brd from above]

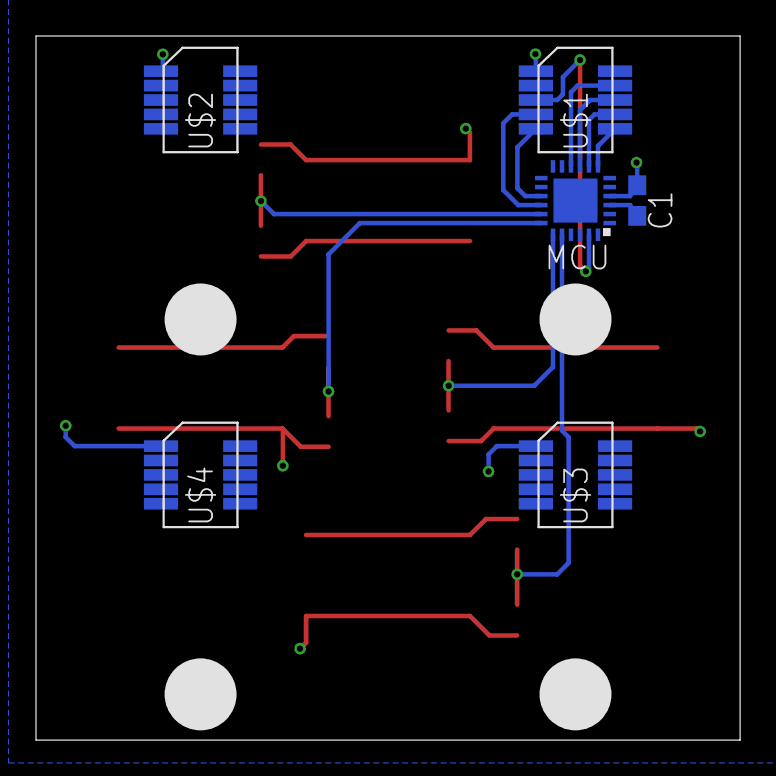
[picture p20: board 2x2_DPad.brd from below]

Board: 2 copper layers, 39.1 x 39.1 mm, 18 parts (6 on the bottom side), 17 nets.

Parts:
C1: 100nF; C0603
C2, C3, C4, C5: 20nF; C0603
DOWN: TASTER
LEFT: TASTER
MCU: ATTINY1614/16/17; QFN24-4X4
R1, R2, R3, R4: 1k; R0603
RIGHT: TASTER
U$1, U$2, U$3, U$4: MOLEX-STACKINGHEADER; 53307-1071
UP: TASTER

Connections:
+5V: C1.1, MCU.4, U$1.P$1, U$2.P$1, U$3.P$1, U$4.P$1
ADD0: MCU.7, U$1.P$6
ADD1: MCU.8, U$1.P$7
ADD2: MCU.9, U$1.P$8
ADD3: MCU.10, U$1.P$9
DOWN: C3.1, MCU.20, R1.1
GND: C1.2, C2.2, C3.2, C4.2, C5.2, DOWN.B0, DOWN.B1, LEFT.B0, LEFT.B1, MCU.3, RIGHT.B0, RIGHT.B1, U$1.P$10, U$2.P$10, U$3.P$10, U$4.P$10, UP.B0, UP.B1
LEFT: C4.1, MCU.19, R3.1
unnamed: DOWN.A0, DOWN.A1, R1.2
unnamed: LEFT.A0, LEFT.A1, R3.2
unnamed: R2.2, UP.A0, UP.A1
unnamed: R4.2, RIGHT.A0, RIGHT.A1
RIGHT: C5.1, MCU.18, R4.1
SCL: MCU.16, U$1.P$4
SDA: MCU.15, U$1.P$5
UP: C2.1, MCU.17, R2.1
UPDI: MCU.23, U$1.P$3
