Wizcat22/HeRo-Mini/Software/QDEC/QDEC/src/driver_init.c

/**
 * \file
 *
 * \brief Driver initialization.
 *
 (c) 2018 Microchip Technology Inc. and its subsidiaries.

    Subject to your compliance with these terms,you may use this software and
    any derivatives exclusively with Microchip products.It is your responsibility
    to comply with third party license terms applicable to your use of third party
    software (including open source software) that may accompany Microchip software.

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
    IN NO EVENT WILL MICROCHIP BE LIABLE FOR ANY INDIRECT, SPECIAL, PUNITIVE,
    INCIDENTAL OR CONSEQUENTIAL LOSS, DAMAGE, COST OR EXPENSE OF ANY KIND
    WHATSOEVER RELATED TO THE SOFTWARE, HOWEVER CAUSED, EVEN IF MICROCHIP HAS
    BEEN ADVISED OF THE POSSIBILITY OR THE DAMAGES ARE FORESEEABLE. TO THE
    FULLEST EXTENT ALLOWED BY LAW, MICROCHIP'S TOTAL LIABILITY ON ALL CLAIMS IN
    ANY WAY RELATED TO THIS SOFTWARE WILL NOT EXCEED THE AMOUNT OF FEES, IF ANY,
    THAT YOU HAVE PAID DIRECTLY TO MICROCHIP FOR THIS SOFTWARE.
 *
 */

/*
 * Code generated by START.
 *
 * This file will be overwritten when reconfiguring your START project.
 * Please copy examples or other code you want to keep to a separate file
 * to avoid losing it when reconfiguring.
 */

#include "driver_init.h"
#include <system.h>

void T_ENC_initialization(void)
{

	T_ENC_init();
}

void T_MOTOR_initialization(void)
{

	// Set pin direction to output
	PC4_set_dir(PORT_DIR_OUT);

	PC4_set_level(
	    // <y> Initial level
	    // <id> pad_initial_level
	    // <false"> Low
	    // <true"> High
	    false);

	T_MOTOR_init();
}

void RTC_PID_initialization(void)
{
	RTC_PID_init();
}

/* configure pins and initialize registers */
void SLEEP_initialization(void)
{
	SLEEP_init();
}

void EVENT_ENC_initialization(void)
{

	EVENT_ENC_init();
}

/* Configure pins and initialize registers */
void USART_DBG_initialization(void)
{

	// Set pin direction to input
	PE2_set_dir(PORT_DIR_IN);

	// Set pin direction to output
	PE3_set_dir(PORT_DIR_OUT);

	PE3_set_level(
	    // <y> Initial level
	    // <id> pad_initial_level
	    // <false"> Low
	    // <true"> High
	    false);

	USART_DBG_init();
}

/**
 * \brief System initialization
 */
void system_init()
{
	mcu_init();

	/* PORT setting on PC3 */

	// Set pin direction to output
	MOTOR_DIR_set_dir(PORT_DIR_OUT);

	MOTOR_DIR_set_level(
	    // <y> Initial level
	    // <id> pad_initial_level
	    // <false"> Low
	    // <true"> High
	    false);

	/* PORT setting on PD0 */

	ENCA_int_level(
	    // <y> Pin Input/Sense Configuration
	    // <id> pad_isc
	    // <PORT_ISC_BOTHEDGES_gc"> Sense Both Edges
	    // <PORT_ISC_RISING_gc"> Sense Rising Edge
	    // <PORT_ISC_FALLING_gc"> Sense Falling Edge
	    // <PORT_ISC_INPUT_DISABLE_gc"> Digital Input Buffer disabled
	    // <PORT_ISC_LEVEL_gc"> Sense low Level
	    PORT_ISC_LEVEL_gc);

	ENCA_int_level(
	    // <y> port vector 0 int level
	    // <id> pad_int0lvl
	    // <PORT_INT0LVL_OFF_gc"> Interrupt Disabled
	    // <PORT_INT0LVL_LO_gc"> Low Level
	    // <PORT_INT0LVL_MED_gc"> Medium Level
	    // <PORT_INT0LVL_HI_gc"> High Level
	    PORT_INT0LVL_OFF_gc);

	ENCA_int_level(
	    // <y> port vector 1 int level
	    // <id> pad_int1lvl
	    // <PORT_INT1LVL_OFF_gc"> Interrupt Disabled
	    // <PORT_INT1LVL_LO_gc"> Low Level
	    // <PORT_INT1LVL_MED_gc"> Medium Level
	    // <PORT_INT1LVL_HI_gc"> High Level
	    PORT_INT1LVL_OFF_gc);

	ENCA_int0_mask(
	    // <o> port vector 0 int mask
	    // <id> pad_int0msk
	    // <0=> 0
	    // <1=> 1
	    // <2=> 2
	    // <3=> 3
	    // <4=> 4
	    // <5=> 5
	    // <6=> 6
	    // <7=> 7
	    // <8=> 8
	    // <9=> 9
	    // <10=> 10
	    // <11=> 11
	    // <12=> 12
	    // <13=> 13
	    // <14=> 14
	    0x0);

	ENCA_int1_mask(
	    // <o> port vector 1 int mask
	    // <id> pad_int1msk
	    // <0=> 0
	    // <1=> 1
	    // <2=> 2
	    // <3=> 3
	    // <4=> 4
	    // <5=> 5
	    // <6=> 6
	    // <7=> 7
	    // <8=> 8
	    // <9=> 9
	    // <10=> 10
	    // <11=> 11
	    // <12=> 12
	    // <13=> 13
	    // <14=> 14
	    0x0);

	/* PORT setting on PD1 */

	ENCB_int_level(
	    // <y> Pin Input/Sense Configuration
	    // <id> pad_isc
	    // <PORT_ISC_BOTHEDGES_gc"> Sense Both Edges
	    // <PORT_ISC_RISING_gc"> Sense Rising Edge
	    // <PORT_ISC_FALLING_gc"> Sense Falling Edge
	    // <PORT_ISC_INPUT_DISABLE_gc"> Digital Input Buffer disabled
	    // <PORT_ISC_LEVEL_gc"> Sense low Level
	    PORT_ISC_LEVEL_gc);

	ENCB_int_level(
	    // <y> port vector 0 int level
	    // <id> pad_int0lvl
	    // <PORT_INT0LVL_OFF_gc"> Interrupt Disabled
	    // <PORT_INT0LVL_LO_gc"> Low Level
	    // <PORT_INT0LVL_MED_gc"> Medium Level
	    // <PORT_INT0LVL_HI_gc"> High Level
	    PORT_INT0LVL_OFF_gc);

	ENCB_int_level(
	    // <y> port vector 1 int level
	    // <id> pad_int1lvl
	    // <PORT_INT1LVL_OFF_gc"> Interrupt Disabled
	    // <PORT_INT1LVL_LO_gc"> Low Level
	    // <PORT_INT1LVL_MED_gc"> Medium Level
	    // <PORT_INT1LVL_HI_gc"> High Level
	    PORT_INT1LVL_OFF_gc);

	ENCB_int0_mask(
	    // <o> port vector 0 int mask
	    // <id> pad_int0msk
	    // <0=> 0
	    // <1=> 1
	    // <2=> 2
	    // <3=> 3
	    // <4=> 4
	    // <5=> 5
	    // <6=> 6
	    // <7=> 7
	    // <8=> 8
	    // <9=> 9
	    // <10=> 10
	    // <11=> 11
	    // <12=> 12
	    // <13=> 13
	    // <14=> 14
	    0x0);

	ENCB_int1_mask(
	    // <o> port vector 1 int mask
	    // <id> pad_int1msk
	    // <0=> 0
	    // <1=> 1
	    // <2=> 2
	    // <3=> 3
	    // <4=> 4
	    // <5=> 5
	    // <6=> 6
	    // <7=> 7
	    // <8=> 8
	    // <9=> 9
	    // <10=> 10
	    // <11=> 11
	    // <12=> 12
	    // <13=> 13
	    // <14=> 14
	    0x0);

	T_ENC_initialization();

	T_MOTOR_initialization();

	OSC_init();

	CLK_init();

	RTC_PID_initialization();

	PMIC_init();

	SLEEP_initialization();

	EVENT_ENC_initialization();

	USART_DBG_initialization();
}
