Wizcat22/HeRo-Mini/Software/QDEC/QDEC/include/atmel_start_pins.h

/*
 * Code generated from Atmel Start.
 *
 * This file will be overwritten when reconfiguring your Atmel Start project.
 * Please copy examples or other code you want to keep to a separate file
 * to avoid losing it when reconfiguring.
 */
#ifndef ATMEL_START_PINS_H_INCLUDED
#define ATMEL_START_PINS_H_INCLUDED

#include <port.h>

/**
 * \brief Set MOTOR_DIR output & pull configuration
 *
 * Configure pin to pull up, down or disable pull mode, supported pull
 * modes are defined by device used
 *
 * \param[in] output_pull_mode Pin output & pull mode
 */
static inline void MOTOR_DIR_set_output_pull_mode(const enum port_output_pull_mode output_pull_mode)
{
	PORTC_set_pin_output_pull_mode(3, output_pull_mode);
}

/**
 * \brief Set MOTOR_DIR data direction
 *
 * Select if the pin data direction is input, output or disabled.
 * If disabled state is not possible, this function throws an assert.
 *
 * \param[in] direction PORT_DIR_IN  = Data direction in
 *                      PORT_DIR_OUT = Data direction out
 *                      PORT_DIR_OFF = Disables the pin
 *                      (low power state)
 */
static inline void MOTOR_DIR_set_dir(const enum port_dir dir)
{
	PORTC_set_pin_dir(3, dir);
}

/**
 * \brief Set MOTOR_DIR input/sense configuration
 *
 * Enable/disable MOTOR_DIR digital input buffer and pin change interrupt,
 * select pin interrupt edge/level sensing mode
 *
 * \param[in] isc PORT_ISC_BOTHEDGES_gc     = Sense Both Edges
 *                PORT_ISC_RISING_gc        = Sense Rising Edge
 *                PORT_ISC_FALLING_gc       = Sense Falling Edge
 *                PORT_ISC_INPUT_DISABLE_gc = Digital Input Buffer disabled
 *                PORT_ISC_LEVEL_gc         = Sense low Level
 */
static inline void MOTOR_DIR_set_isc(const PORT_ISC_t isc)
{
	PORTC_pin_set_isc(3, isc);
}

/**
 * \brief Set MOTOR_DIR inverted mode
 *
 * Enable or disable inverted I/O on a pin
 *
 * \param[in] inverted true  = I/O on MOTOR_DIR is inverted
 *                     false = I/O on MOTOR_DIR is not inverted
 */
static inline void MOTOR_DIR_set_inverted(const bool inverted)
{
	PORTC_pin_set_inverted(3, inverted);
}

/**
 * \brief Set MOTOR_DIR level
 *
 * Sets output level on a pin
 *
 * \param[in] level true  = Pin level set to "high" state
 *                  false = Pin level set to "low" state
 */
static inline void MOTOR_DIR_set_level(const bool level)
{
	PORTC_set_pin_level(3, level);
}

/**
 * \brief Toggle output level on MOTOR_DIR
 *
 * Toggle the pin level
 */
static inline void MOTOR_DIR_toggle_level()
{
	PORTC_toggle_pin_level(3);
}

/**
 * \brief Get level on MOTOR_DIR
 *
 * Reads the level on a pin
 */
static inline bool MOTOR_DIR_get_level()
{
	return PORTC_get_pin_level(3);
}

/**
 * \brief Set MOTOR_DIR interrupt level
 *
 * Sets interrupt level for port
 *
 * \param[in] level Value to write to the port register
 */
static inline void MOTOR_DIR_int_level(const uint8_t level)
{
	PORTC_set_int_level(level);
}

/**
 * \brief Set MOTOR_DIR interrupt vector 0 mask
 *
 * Sets interrupt mask for port vector 0
 *
 * \param[in] value Value to write to the port register
 */
static inline void MOTOR_DIR_int0_mask(const uint8_t value)
{
	PORTC_write_int0_mask(value);
}

/**
 * \brief Set MOTOR_DIR interrupt vector 1 mask
 *
 * Sets interrupt mask for port vector 1
 *
 * \param[in] value Value to write to the port register
 */
static inline void MOTOR_DIR_int1_mask(const uint8_t value)
{
	PORTC_write_int1_mask(value);
}

/**
 * \brief Set PC4 output & pull configuration
 *
 * Configure pin to pull up, down or disable pull mode, supported pull
 * modes are defined by device used
 *
 * \param[in] output_pull_mode Pin output & pull mode
 */
static inline void PC4_set_output_pull_mode(const enum port_output_pull_mode output_pull_mode)
{
	PORTC_set_pin_output_pull_mode(4, output_pull_mode);
}

/**
 * \brief Set PC4 data direction
 *
 * Select if the pin data direction is input, output or disabled.
 * If disabled state is not possible, this function throws an assert.
 *
 * \param[in] direction PORT_DIR_IN  = Data direction in
 *                      PORT_DIR_OUT = Data direction out
 *                      PORT_DIR_OFF = Disables the pin
 *                      (low power state)
 */
static inline void PC4_set_dir(const enum port_dir dir)
{
	PORTC_set_pin_dir(4, dir);
}

/**
 * \brief Set PC4 input/sense configuration
 *
 * Enable/disable PC4 digital input buffer and pin change interrupt,
 * select pin interrupt edge/level sensing mode
 *
 * \param[in] isc PORT_ISC_BOTHEDGES_gc     = Sense Both Edges
 *                PORT_ISC_RISING_gc        = Sense Rising Edge
 *                PORT_ISC_FALLING_gc       = Sense Falling Edge
 *                PORT_ISC_INPUT_DISABLE_gc = Digital Input Buffer disabled
 *                PORT_ISC_LEVEL_gc         = Sense low Level
 */
static inline void PC4_set_isc(const PORT_ISC_t isc)
{
	PORTC_pin_set_isc(4, isc);
}

/**
 * \brief Set PC4 inverted mode
 *
 * Enable or disable inverted I/O on a pin
 *
 * \param[in] inverted true  = I/O on PC4 is inverted
 *                     false = I/O on PC4 is not inverted
 */
static inline void PC4_set_inverted(const bool inverted)
{
	PORTC_pin_set_inverted(4, inverted);
}

/**
 * \brief Set PC4 level
 *
 * Sets output level on a pin
 *
 * \param[in] level true  = Pin level set to "high" state
 *                  false = Pin level set to "low" state
 */
static inline void PC4_set_level(const bool level)
{
	PORTC_set_pin_level(4, level);
}

/**
 * \brief Toggle output level on PC4
 *
 * Toggle the pin level
 */
static inline void PC4_toggle_level()
{
	PORTC_toggle_pin_level(4);
}

/**
 * \brief Get level on PC4
 *
 * Reads the level on a pin
 */
static inline bool PC4_get_level()
{
	return PORTC_get_pin_level(4);
}

/**
 * \brief Set PC4 interrupt level
 *
 * Sets interrupt level for port
 *
 * \param[in] level Value to write to the port register
 */
static inline void PC4_int_level(const uint8_t level)
{
	PORTC_set_int_level(level);
}

/**
 * \brief Set PC4 interrupt vector 0 mask
 *
 * Sets interrupt mask for port vector 0
 *
 * \param[in] value Value to write to the port register
 */
static inline void PC4_int0_mask(const uint8_t value)
{
	PORTC_write_int0_mask(value);
}

/**
 * \brief Set PC4 interrupt vector 1 mask
 *
 * Sets interrupt mask for port vector 1
 *
 * \param[in] value Value to write to the port register
 */
static inline void PC4_int1_mask(const uint8_t value)
{
	PORTC_write_int1_mask(value);
}

/**
 * \brief Set ENCA output & pull configuration
 *
 * Configure pin to pull up, down or disable pull mode, supported pull
 * modes are defined by device used
 *
 * \param[in] output_pull_mode Pin output & pull mode
 */
static inline void ENCA_set_output_pull_mode(const enum port_output_pull_mode output_pull_mode)
{
	PORTD_set_pin_output_pull_mode(0, output_pull_mode);
}

/**
 * \brief Set ENCA data direction
 *
 * Select if the pin data direction is input, output or disabled.
 * If disabled state is not possible, this function throws an assert.
 *
 * \param[in] direction PORT_DIR_IN  = Data direction in
 *                      PORT_DIR_OUT = Data direction out
 *                      PORT_DIR_OFF = Disables the pin
 *                      (low power state)
 */
static inline void ENCA_set_dir(const enum port_dir dir)
{
	PORTD_set_pin_dir(0, dir);
}

/**
 * \brief Set ENCA input/sense configuration
 *
 * Enable/disable ENCA digital input buffer and pin change interrupt,
 * select pin interrupt edge/level sensing mode
 *
 * \param[in] isc PORT_ISC_BOTHEDGES_gc     = Sense Both Edges
 *                PORT_ISC_RISING_gc        = Sense Rising Edge
 *                PORT_ISC_FALLING_gc       = Sense Falling Edge
 *                PORT_ISC_INPUT_DISABLE_gc = Digital Input Buffer disabled
 *                PORT_ISC_LEVEL_gc         = Sense low Level
 */
static inline void ENCA_set_isc(const PORT_ISC_t isc)
{
	PORTD_pin_set_isc(0, isc);
}

/**
 * \brief Set ENCA inverted mode
 *
 * Enable or disable inverted I/O on a pin
 *
 * \param[in] inverted true  = I/O on ENCA is inverted
 *                     false = I/O on ENCA is not inverted
 */
static inline void ENCA_set_inverted(const bool inverted)
{
	PORTD_pin_set_inverted(0, inverted);
}

/**
 * \brief Set ENCA level
 *
 * Sets output level on a pin
 *
 * \param[in] level true  = Pin level set to "high" state
 *                  false = Pin level set to "low" state
 */
static inline void ENCA_set_level(const bool level)
{
	PORTD_set_pin_level(0, level);
}

/**
 * \brief Toggle output level on ENCA
 *
 * Toggle the pin level
 */
static inline void ENCA_toggle_level()
{
	PORTD_toggle_pin_level(0);
}

/**
 * \brief Get level on ENCA
 *
 * Reads the level on a pin
 */
static inline bool ENCA_get_level()
{
	return PORTD_get_pin_level(0);
}

/**
 * \brief Set ENCA interrupt level
 *
 * Sets interrupt level for port
 *
 * \param[in] level Value to write to the port register
 */
static inline void ENCA_int_level(const uint8_t level)
{
	PORTD_set_int_level(level);
}

/**
 * \brief Set ENCA interrupt vector 0 mask
 *
 * Sets interrupt mask for port vector 0
 *
 * \param[in] value Value to write to the port register
 */
static inline void ENCA_int0_mask(const uint8_t value)
{
	PORTD_write_int0_mask(value);
}

/**
 * \brief Set ENCA interrupt vector 1 mask
 *
 * Sets interrupt mask for port vector 1
 *
 * \param[in] value Value to write to the port register
 */
static inline void ENCA_int1_mask(const uint8_t value)
{
	PORTD_write_int1_mask(value);
}

/**
 * \brief Set ENCB output & pull configuration
 *
 * Configure pin to pull up, down or disable pull mode, supported pull
 * modes are defined by device used
 *
 * \param[in] output_pull_mode Pin output & pull mode
 */
static inline void ENCB_set_output_pull_mode(const enum port_output_pull_mode output_pull_mode)
{
	PORTD_set_pin_output_pull_mode(1, output_pull_mode);
}

/**
 * \brief Set ENCB data direction
 *
 * Select if the pin data direction is input, output or disabled.
 * If disabled state is not possible, this function throws an assert.
 *
 * \param[in] direction PORT_DIR_IN  = Data direction in
 *                      PORT_DIR_OUT = Data direction out
 *                      PORT_DIR_OFF = Disables the pin
 *                      (low power state)
 */
static inline void ENCB_set_dir(const enum port_dir dir)
{
	PORTD_set_pin_dir(1, dir);
}

/**
 * \brief Set ENCB input/sense configuration
 *
 * Enable/disable ENCB digital input buffer and pin change interrupt,
 * select pin interrupt edge/level sensing mode
 *
 * \param[in] isc PORT_ISC_BOTHEDGES_gc     = Sense Both Edges
 *                PORT_ISC_RISING_gc        = Sense Rising Edge
 *                PORT_ISC_FALLING_gc       = Sense Falling Edge
 *                PORT_ISC_INPUT_DISABLE_gc = Digital Input Buffer disabled
 *                PORT_ISC_LEVEL_gc         = Sense low Level
 */
static inline void ENCB_set_isc(const PORT_ISC_t isc)
{
	PORTD_pin_set_isc(1, isc);
}

/**
 * \brief Set ENCB inverted mode
 *
 * Enable or disable inverted I/O on a pin
 *
 * \param[in] inverted true  = I/O on ENCB is inverted
 *                     false = I/O on ENCB is not inverted
 */
static inline void ENCB_set_inverted(const bool inverted)
{
	PORTD_pin_set_inverted(1, inverted);
}

/**
 * \brief Set ENCB level
 *
 * Sets output level on a pin
 *
 * \param[in] level true  = Pin level set to "high" state
 *                  false = Pin level set to "low" state
 */
static inline void ENCB_set_level(const bool level)
{
	PORTD_set_pin_level(1, level);
}

/**
 * \brief Toggle output level on ENCB
 *
 * Toggle the pin level
 */
static inline void ENCB_toggle_level()
{
	PORTD_toggle_pin_level(1);
}

/**
 * \brief Get level on ENCB
 *
 * Reads the level on a pin
 */
static inline bool ENCB_get_level()
{
	return PORTD_get_pin_level(1);
}

/**
 * \brief Set ENCB interrupt level
 *
 * Sets interrupt level for port
 *
 * \param[in] level Value to write to the port register
 */
static inline void ENCB_int_level(const uint8_t level)
{
	PORTD_set_int_level(level);
}

/**
 * \brief Set ENCB interrupt vector 0 mask
 *
 * Sets interrupt mask for port vector 0
 *
 * \param[in] value Value to write to the port register
 */
static inline void ENCB_int0_mask(const uint8_t value)
{
	PORTD_write_int0_mask(value);
}

/**
 * \brief Set ENCB interrupt vector 1 mask
 *
 * Sets interrupt mask for port vector 1
 *
 * \param[in] value Value to write to the port register
 */
static inline void ENCB_int1_mask(const uint8_t value)
{
	PORTD_write_int1_mask(value);
}

/**
 * \brief Set PE2 output & pull configuration
 *
 * Configure pin to pull up, down or disable pull mode, supported pull
 * modes are defined by device used
 *
 * \param[in] output_pull_mode Pin output & pull mode
 */
static inline void PE2_set_output_pull_mode(const enum port_output_pull_mode output_pull_mode)
{
	PORTE_set_pin_output_pull_mode(2, output_pull_mode);
}

/**
 * \brief Set PE2 data direction
 *
 * Select if the pin data direction is input, output or disabled.
 * If disabled state is not possible, this function throws an assert.
 *
 * \param[in] direction PORT_DIR_IN  = Data direction in
 *                      PORT_DIR_OUT = Data direction out
 *                      PORT_DIR_OFF = Disables the pin
 *                      (low power state)
 */
static inline void PE2_set_dir(const enum port_dir dir)
{
	PORTE_set_pin_dir(2, dir);
}

/**
 * \brief Set PE2 input/sense configuration
 *
 * Enable/disable PE2 digital input buffer and pin change interrupt,
 * select pin interrupt edge/level sensing mode
 *
 * \param[in] isc PORT_ISC_BOTHEDGES_gc     = Sense Both Edges
 *                PORT_ISC_RISING_gc        = Sense Rising Edge
 *                PORT_ISC_FALLING_gc       = Sense Falling Edge
 *                PORT_ISC_INPUT_DISABLE_gc = Digital Input Buffer disabled
 *                PORT_ISC_LEVEL_gc         = Sense low Level
 */
static inline void PE2_set_isc(const PORT_ISC_t isc)
{
	PORTE_pin_set_isc(2, isc);
}

/**
 * \brief Set PE2 inverted mode
 *
 * Enable or disable inverted I/O on a pin
 *
 * \param[in] inverted true  = I/O on PE2 is inverted
 *                     false = I/O on PE2 is not inverted
 */
static inline void PE2_set_inverted(const bool inverted)
{
	PORTE_pin_set_inverted(2, inverted);
}

/**
 * \brief Set PE2 level
 *
 * Sets output level on a pin
 *
 * \param[in] level true  = Pin level set to "high" state
 *                  false = Pin level set to "low" state
 */
static inline void PE2_set_level(const bool level)
{
	PORTE_set_pin_level(2, level);
}

/**
 * \brief Toggle output level on PE2
 *
 * Toggle the pin level
 */
static inline void PE2_toggle_level()
{
	PORTE_toggle_pin_level(2);
}

/**
 * \brief Get level on PE2
 *
 * Reads the level on a pin
 */
static inline bool PE2_get_level()
{
	return PORTE_get_pin_level(2);
}

/**
 * \brief Set PE2 interrupt level
 *
 * Sets interrupt level for port
 *
 * \param[in] level Value to write to the port register
 */
static inline void PE2_int_level(const uint8_t level)
{
	PORTE_set_int_level(level);
}

/**
 * \brief Set PE2 interrupt vector 0 mask
 *
 * Sets interrupt mask for port vector 0
 *
 * \param[in] value Value to write to the port register
 */
static inline void PE2_int0_mask(const uint8_t value)
{
	PORTE_write_int0_mask(value);
}

/**
 * \brief Set PE2 interrupt vector 1 mask
 *
 * Sets interrupt mask for port vector 1
 *
 * \param[in] value Value to write to the port register
 */
static inline void PE2_int1_mask(const uint8_t value)
{
	PORTE_write_int1_mask(value);
}

/**
 * \brief Set PE3 output & pull configuration
 *
 * Configure pin to pull up, down or disable pull mode, supported pull
 * modes are defined by device used
 *
 * \param[in] output_pull_mode Pin output & pull mode
 */
static inline void PE3_set_output_pull_mode(const enum port_output_pull_mode output_pull_mode)
{
	PORTE_set_pin_output_pull_mode(3, output_pull_mode);
}

/**
 * \brief Set PE3 data direction
 *
 * Select if the pin data direction is input, output or disabled.
 * If disabled state is not possible, this function throws an assert.
 *
 * \param[in] direction PORT_DIR_IN  = Data direction in
 *                      PORT_DIR_OUT = Data direction out
 *                      PORT_DIR_OFF = Disables the pin
 *                      (low power state)
 */
static inline void PE3_set_dir(const enum port_dir dir)
{
	PORTE_set_pin_dir(3, dir);
}

/**
 * \brief Set PE3 input/sense configuration
 *
 * Enable/disable PE3 digital input buffer and pin change interrupt,
 * select pin interrupt edge/level sensing mode
 *
 * \param[in] isc PORT_ISC_BOTHEDGES_gc     = Sense Both Edges
 *                PORT_ISC_RISING_gc        = Sense Rising Edge
 *                PORT_ISC_FALLING_gc       = Sense Falling Edge
 *                PORT_ISC_INPUT_DISABLE_gc = Digital Input Buffer disabled
 *                PORT_ISC_LEVEL_gc         = Sense low Level
 */
static inline void PE3_set_isc(const PORT_ISC_t isc)
{
	PORTE_pin_set_isc(3, isc);
}

/**
 * \brief Set PE3 inverted mode
 *
 * Enable or disable inverted I/O on a pin
 *
 * \param[in] inverted true  = I/O on PE3 is inverted
 *                     false = I/O on PE3 is not inverted
 */
static inline void PE3_set_inverted(const bool inverted)
{
	PORTE_pin_set_inverted(3, inverted);
}

/**
 * \brief Set PE3 level
 *
 * Sets output level on a pin
 *
 * \param[in] level true  = Pin level set to "high" state
 *                  false = Pin level set to "low" state
 */
static inline void PE3_set_level(const bool level)
{
	PORTE_set_pin_level(3, level);
}

/**
 * \brief Toggle output level on PE3
 *
 * Toggle the pin level
 */
static inline void PE3_toggle_level()
{
	PORTE_toggle_pin_level(3);
}

/**
 * \brief Get level on PE3
 *
 * Reads the level on a pin
 */
static inline bool PE3_get_level()
{
	return PORTE_get_pin_level(3);
}

/**
 * \brief Set PE3 interrupt level
 *
 * Sets interrupt level for port
 *
 * \param[in] level Value to write to the port register
 */
static inline void PE3_int_level(const uint8_t level)
{
	PORTE_set_int_level(level);
}

/**
 * \brief Set PE3 interrupt vector 0 mask
 *
 * Sets interrupt mask for port vector 0
 *
 * \param[in] value Value to write to the port register
 */
static inline void PE3_int0_mask(const uint8_t value)
{
	PORTE_write_int0_mask(value);
}

/**
 * \brief Set PE3 interrupt vector 1 mask
 *
 * Sets interrupt mask for port vector 1
 *
 * \param[in] value Value to write to the port register
 */
static inline void PE3_int1_mask(const uint8_t value)
{
	PORTE_write_int1_mask(value);
}

#endif /* ATMEL_START_PINS_H_INCLUDED */
