Wizcat22/HeRo-Mini/(commit log)

2017-09-27 New Parts
    [BEARING.0003.ipt, BEARING.ipt, BODY.0006.iam, BODY.iam, BODY_BOTTOM.0005.ipt, BODY_BOTTOM.ipt, BODY_TOP.0003.ipt, BODY_TOP.ipt]
2017-10-29 Minor changes
    [BODY.0006.iam, BODY.0008.iam, BODY.iam, BODY_BOTTOM.0005.ipt, BODY_BOTTOM.0006.ipt, BODY_BOTTOM.ipt, BODY_BOTTOM.stl, BODY_TOP.0003.ipt]
2017-11-28 Initial upload
    [Mainboard.brd, Mainboard.sch]
2017-12-18 Added missing leg controller + layout
    [Mainboard.brd, Mainboard.sch]
2017-12-18 Finished layout for current circuit
    [Mainboard.brd, Mainboard.sch]
2018-01-05 Adjusted all parts, added screws and nuts
    [BEARING.0003.ipt, BEARING.0006.ipt, BEARING.ipt, BODY.0008.iam, BODY.0013.iam, BODY.iam, BODY_BOTTOM.0006.ipt, BODY_BOTTOM.0008.ipt]
2018-01-05 Added 4 holes
    [Mainboard.brd]
2018-01-24 New Leg
    [FEMUR.0002_1.ipt, FEMUR.ipt, FEMUR_A.0008.ipt, FEMUR_A.0009.ipt, FEMUR_A.ipt, HeRoMini.0012.iam, HeRoMini.0013.iam, HeRoMini.iam]
2018-04-12 Finished Servocontroller design
    [Mainboard.brd, Mainboard.sch]
2018-05-01 Minor changes in controller, new mainboard
    [Controller.brd, Controller.sch, Mainboard.brd, Mainboard.sch]
2018-05-01 Changed PCB size to 25mmx25mm
    [Controller.brd, Controller.sch]
2018-05-02 WIP Mainboard design
    [Mainboard.brd, Mainboard.sch]
2018-06-14 Implemented all HAL functions
    Tested: led,pwm,sense
    TODO: test i2c communication
2018-06-17 Added servo functions
2018-06-21 implemented "servo_write_deg()"
2018-06-24 New classes for every component (Led, Sensor, Servo)
2018-07-13 Minor Redesign
    Replace ESP32 Eval board with own design
    [Mainboard.brd, Mainboard.sch]
2018-07-19 added new parts, added all signals
    [Mainboard.brd, Mainboard.sch]
2018-07-20 minor adjustments, finished routing
    [Mainboard.brd, Mainboard.sch]
2018-07-20 Added sketch for pcb placement
    [BODY_BOTTOM.0010.ipt, BODY_BOTTOM.0011.ipt, BODY_BOTTOM.ipt]
2018-07-30 finalised routing, added 3D-Models
    [Controller.brd, Controller.sch, Mainboard.brd, Mainboard.sch]
2018-07-30 New Design, added PCBs (and Placeholders)
    [BEARING.0012.ipt, BEARING.ipt, BODY.0018.iam, BODY.iam, BODY_BOTTOM.0011.ipt, BODY_BOTTOM.ipt, BODY_COVER.ipt, BODY_TOP.0013.ipt]
2018-08-02 Tested I2C communication
2018-08-03 Added I2C test
2018-09-27 Bug fixes, added X-Formation
    [Controller.iam, HeRoMini2.iam, LEG.iam, LEG2.iam]
2018-10-29 Initial Upload of new Leg Prototype
    [Prototype.sch]
2018-11-12 Upload Gamepad
    [Gamepad.brd, Gamepad.sch, Prototype.brd, Prototype.sch]
2018-11-25 Motor-Control test project
    Testing QDEC and PID
