Wizcat22/HeRo-Mini/(notices)

Notices in the files:
parts and their libraries:
InputOutputIO: Copyright: Würth Elektronik
